towre676-cloud/hydrophone/receipts/symphony/clay_and_water_mobile.png

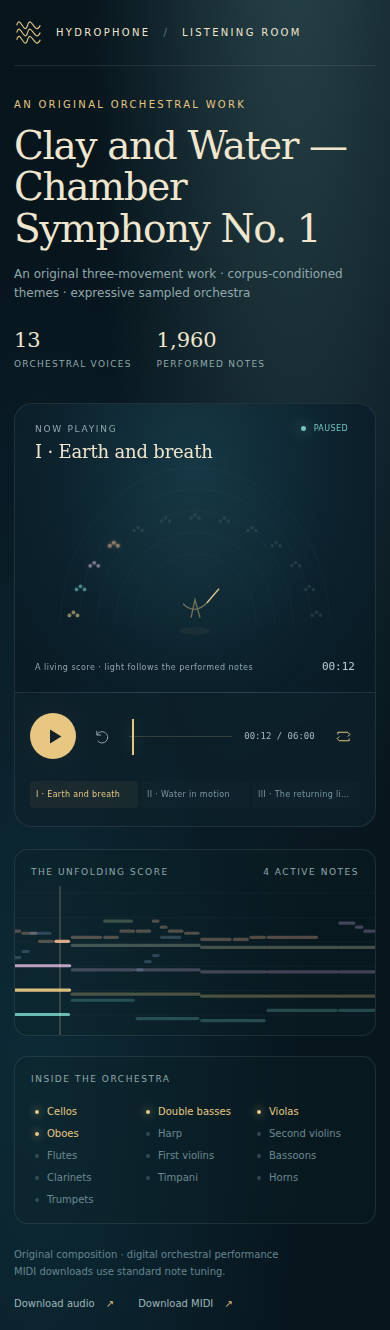
receipts/symphony/clay_and_water_mobile.png
