towre676-cloud/hydrophone/receipts/symphony/clay_and_water_desktop.png

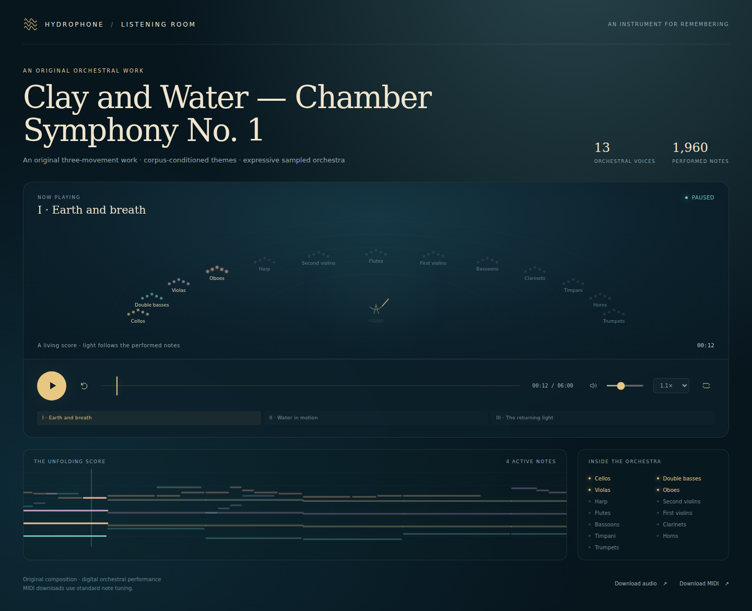
receipts/symphony/clay_and_water_desktop.png
