towre676-cloud/hydrophone/design/fusion_design/README.txt

FUSION INSTRUMENT - ENGINEERING DESIGN 0.2 - 24 OCTOBER 2026

Start with output/Fusion_Instrument_Design.pdf. Dimensions are nominal, not
measured results. The OpenSCAD file is a fit-check assembly; clamps, seals,
membrane loading, spring temper and sensor calibration need coupon checks.
No hardware has been assembled, bought, tested or connected to repositories.

The physical object uses one clay-controlled shared bridge, four dry strings,
one vented water cell/hydrophone, a slow writer and independent vibration
reference. Dyletsky supplies spelled musical targets; five research repositories
supply distinct mathematical services through proposed unit-bearing contracts.

Run standard-library design arithmetic:
    python src/fusion_reference.py

Run the illustrative passive model (NumPy, SciPy, Matplotlib required):
    python model/passive_instrument_model.py

Open src/Fusion_Instrument_Layout.scad in OpenSCAD. The generated CSG confirms
syntax only; no fabrication/strength claim follows from a rendered assembly.

The new ratio fixture is not a replay of original Dyletsky JavaScript. Source
documents recovered are Claycompute.txt, claycompute_exposition.md.pdf,
dyle2.txt and dyle3.txt. The original hydrophone-and-string description was
not recovered; the combined mechanism is a new, explicitly proposed design.

SOFTWARE INTEGRATION 0.2
Read dyletsky/README.txt for recovered source engines, exact verification and
the executable bridge to the Review Hidden Math session. Open
dyletsky/output/Dyletsky_Fusion_Audition.html to audition offline. The physical
adapter remains disabled; the software now generates and checks real targets.
The cross-session handoff is Fusion_Physical_Integration_Handoff_20261024.json.
