towre676-cloud/hydrophone/hardware/requirements-alignment.txt

# Optional offline electrical loopback timing; no device access.
numpy>=1.24,<3
scipy>=1.10,<2
