towre676-cloud/hydrophone/design/fusion_design/dyletsky/fusion_bridge_notes.txt

FUSION SESSION INTEGRATION - ACTUAL SOFTWARE TARGETS, SYNTHETIC OBSERVATIONS
24 October 2026

The source archive is the other session's Fusion_Decision_Engine_20261024.zip, SHA256 699965824802bb8d4a1157fc5e74255bb4b697c9376a08e1712a056bc66532e2. Safe extraction rejected absolute paths, parent traversal, symbolic links and destinations outside the extraction root. Every file listed in the archive manifest matched its recorded size and SHA256. The copied fusion_engine.py is byte-for-byte unchanged, SHA256 5acc5d9fdfd2a9390f4d73f445bad25b82bbe58a9e322534b57e6dfa92f54cbc. The complete independent replay exactly equals the archived results.json: 600 interval-panel cross-checks, eight minimal three-state obstructions in its original model, original action/task/state costs 1/3/7, failure at closed noise radius 1/2, and archived 12-pitch music Gram determinant 52002816.

The bridge imports that recovered engine and calls its actual optimal_panel function. It does not implement another hypergraph solver. It also calls the recovered independent interval-arrangement checker on the selected action panel. Its API assumes a finite hypothesis pool, fixed acceptable-action sets, independent rectangular bounded reading sets, closed interval endpoints, fixed non-state-changing probes or an explicit reset contract, and a common normalized noise radius. These assumptions have not been established for the proposed physical instrument.

The actual Dyletsky score export used for this run contains 68 software-generated events. The bridge reads its four calibration targets: C4 at 261.626 Hz, D4 at 292.39573306577114 Hz, E4 at 326.759563456652 Hz, and G4 at 391.1253463782126 Hz. These are genuine outputs of the recovered software engine and its export pipeline, not measured string frequencies. Each target is retained with its source spelling, engine identifier, offset in cents and manual-tuning marker. The score file's SHA256 is stored in fusion_bridge_results.json. This bridge tests calibration decisions; the separate event compiler handles the polyphonic common-exciter score and is not implemented here.

For each target, the new application declares six synthetic hypotheses: pitch error -4, 0 or +4 cents relative to that target, crossed with a binary synthetic sensor nuisance code. Candidate actions add either -4 or +4 cents exactly, and a successful action leaves absolute error at most 4 cents. The declared coarse reading has bounded error 2 cents; the fine reading has bounded error 1/2 cent. Their illustrative costs are 1 and 4. A nuisance-code reading costs 2. The recovered exact engine returns action panel coarse_pitch at cost 1, tuning-task panel fine_pitch at cost 4, and full-state panel fine_pitch plus sensor_nuisance_code at cost 6 for all four targets. Costs are not measured time, money, energy or speedup.

At a normalized coarse reading of -1/2, four hypotheses remain compatible: either -4 or 0 cents error, and either nuisance code. The tuning task and complete state both remain unresolved. Nevertheless, RAISE_4_CENTS is successful for all four hypotheses, yielding final error 0 or +4 cents under the declared action model. At +1/2 the corresponding common action is LOWER_4_CENTS. This explicitly retains a useful decision without forcing complete material-state identification. The recovered checker also verifies that enlarging the coarse closed noise radius to 1, meaning 4 cents, breaks the guarantee at the shared endpoint.

The exact certificate concerns the rational normalized-cents table only. Nominal frequencies computed from cents are approximate display arithmetic. Real frequency-estimation uncertainty, drift, action error, clay response, string coupling, unknown water-path response and hydrophone calibration have not been bounded by this example. An out-of-population physical state is not covered. A real correction would require measured actuation limits, remeasurement and a calibration contract. There are no fabricated physical measurements, no physical controller, no new theorem claim and no claim that the package solves the full rheology or control problem.

Run from any directory with Python 3.10 or newer: python /absolute/path/to/dyletsky/fusion_bridge.py --score /absolute/path/to/dyletsky/output/instrument_score.json. The default output is output/fusion_bridge_results.json beside the bridge. Only the standard library is required. Physical execution is disabled in every emitted decision.
