towre676-cloud/hydrophone/docs/INTEGRATION.md

# Shared object and computing boundary

The design session's current Engineering Design0.2 packet is preserved in `design/fusion_design/`. The current computing session supplies `computing/`, its examples/tests, and the earlier Fusion and object handoff archives. The repository is now the shared durable source for these parallel outputs.

The authoritative current design interface description is `design/fusion_design/src/fusion_contracts.json`. The older `docs/handoffs/acquisition_contract.json` remains a draft checkpoint; the design PDF and CAD now supply geometry that was unavailable when that checkpoint was written. Sensor calibration, synchronization, physical drivers and actuator limits remain unqualified in both.

The design packet assigns DynaComp the measured dynamical-model/reduction role; Singularity finite experiment distinguishability; PerfectJet recoverability and bounded decisions; PerfectPower finite program/resource planning; nonlinearhamiltonian a supported single-modal conservative symbolic reference; and Dyletsky labelled pitch targets and excitation phrases. This local computing layer provides concrete grouped interval and score/run formats for those boundaries. It does not claim that external repository APIs have already been imported or executed.

A joint experiment begins with ordered preparation of the clay cartridge, records a declared geometry and time, and preserves slow force/displacement alongside string, direct-vibration and hydrophone channels. Raw paths, hashes, units, calibration records and clock maps accompany the record. One physical excitation is one acquisition group even if it yields many features. State-changing probes need independent prepared replicates or complete sequence models; merely labeling a probe reset does not prove it leaves the target memory intact.

The first acceptance task is to determine whether prepared history differences are observable under confirmation cartridges or days, and whether a bounded diagnostic decision can be replayed. Dynamic transfer features can identify operators while concealing initial state. Slow force complements them in the illustrative SLS model. The new finite-hold calculation propagates memory relaxation instead of freezing its value throughout a nonzero dwell.

Hardware command readiness remains separate from model decision sufficiency. The physical owner must supply measured travel, force, tension and speed envelopes, calibrated transfer paths, timing and drive limits before any recommendation is mapped to actuation. The existing code records this boundary explicitly and emits zero hardware commands.

The prior0.1 packet remains byte-preserved in archives/Fusion_Instrument_Design_Package_v0_1_20261024.zip and its PDF is docs/reports/Fusion_Instrument_Design_v0_1.pdf. The new instrument/ layer adds common-input WAV rendering, joint digital-channel tone features and signed slow writer-port work. The original computing/ layer retains its grouped finite planner, memory enclosures and acquisition auditor.

Canonical fusion.run/1 uses raw_files and the computing auditor. instrument analyze-run accepts that canonical record when explicit analysis.tones frequencies and channel selections are added, preserving logger_time_s. Its smaller standalone record is named hydrophone.signal-run/1. Both score variants retain fusion.score/1 with explicit start_s/onset_s and source_amplitude/amplitude aliases; contradictory aliases reject, and voice identifiers are not silently remapped. The archived36-row twelve-class music proxy and recovered37-row/43-row spelled engines remain distinct.
