towre676-cloud/hydrophone/docs/reports/Fusion_Instrument_Design.pdf

ENGINEERING DESIGN 0.2 / 24 OCTOBER 2026

# A physical fusion instrument

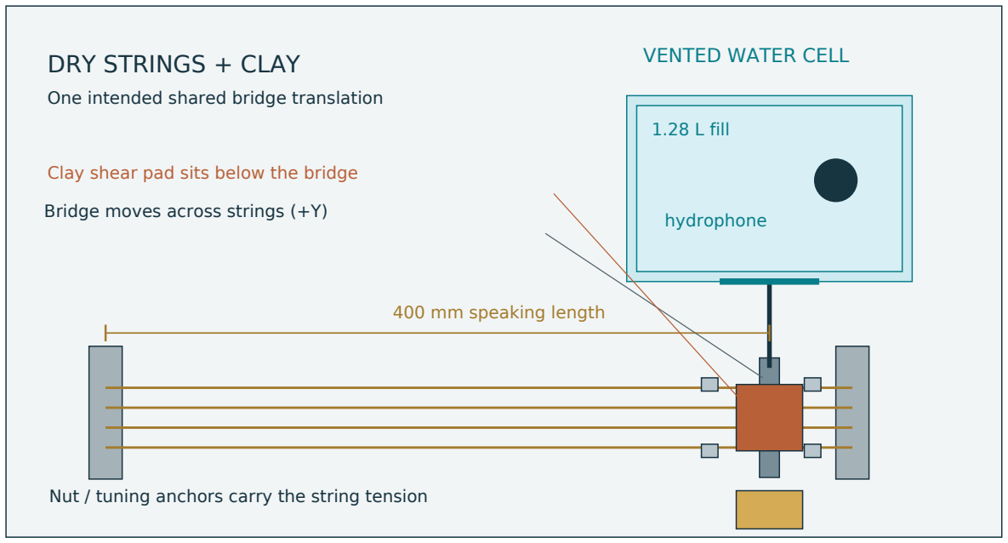
[picture p3: figure]
DRY STRINGS + CLAY; One intended shared bridge translation; VENTED WATER CELL; 1.28 L fill; hydrophone; 400 mm speaking length; Bridge moves across strings (+Y); Clay shear pad sits below the bridge

FUSION / nominal design; no assembled hardware or measured material results | 01

A clay-controlled musical measurement instrument. Four dry strings share a transverse bridge whose motion shears a replaceable clay cartridge. A removable dry rod drives a diaphragm in a vented water cell. A hydrophone records that water-coupled response while a separate vibration reference and a slow force/displacement instrument reveal what the clay actually retains.

Nut / tuning anchors carry the string tension

600 mm

TOP VIEW / millimetres / nominal positions

Rod detaches for clay writing; water never contacts clay or strings.

Dyletsky supplies spelled pitch targets, interval priorities and musical drive phrases. DynaComp predicts selected outputs of a calibrated mechanical model. Singularity chooses distinguishing experiments, PerfectJet checks whether a requested decision is supported, PerfectPower schedules admissible finite drive programs, and nonlinearhamiltonian checks the conservative symbolic reference. Dyletsky score export and the other session’s Fusion decision bridge now execute; acquisition and physical repository adapters remain new work.

Delivered status. This packet supplies nominal geometry, an assembly layout, components, calibration protocol, data contracts and reproducible synthetic calculations. It is a preliminary engineering design, with an explicit path to a first physical experiment. It does not report an assembled object, verified material law, physical computing advantage or completed hardware integration. The recovered Dyletsky and Fusion software integration is documented in the added pages.

# Geometry and construction

FUSION / nominal design; no assembled hardware or measured material results | 02

BRIDGE SECTION / heights shown schematically; Z in mm

String saddle Z=125

Bridge Z=113..125

Flexure tops Z=95

Upper plate Z=86..89

Clay pad Z=78..86

Fixed plate Z=75..78

Leaf free length 40; thin axis is Y

Rod centre Z=85; offset carrier

Stop screws limit Y travel

Four-leaf guide: measure parasitic rotation. Anchors carry axial string load.

Item | Nominal geometry / location
Base / envelope | 600 × 320 × 12 plate; reserve total height 240. X is string direction; Y is bridge motion; Z is height.
Strings | Nut X=60; bridge X=460; afterlength anchor X=510. Y=54,66,78,90; saddle Z=125. Speaking length 400; afterlength 50.
Clay sandwich | 30 × 30 × 8 clay between 40 × 40 × 3 plates. Centre X=460,Y=72. Lower plate Z=75..78; clay 78..86; upper plate 86..89.
Carrier / flexures | Four leaves 40 × 10 × 0.30 spring steel, free Z=55..95, thin direction Y; centres X=424/486,Y=52/92. Bridge crossbar 12 × 72 × 12 at X=454..466,Y=36..108,Z=113..125.
Water cell | Internal X=380..540,Y=160..260,Z=35..135. Six mm walls; fill to Z=115. External extent 172 × 112 × 106. Vented removable lid.
Wet interface | Diaphragm centre X=460,Z=85; external plane Y=154. Forty mm clear aperture. Dry rod diameter 3, centre Z=85. Hydrophone centre X=500,Y=215,Z=80.

Base drilling, bracket holes and cable routes must follow purchased component drawings. The OpenSCAD assembly checks nominal fit and load-path arrangement; omitted fasteners, saddle caps, seals and electronics are not fabrication details inferred from the render. Use captive grooved saddles or light retaining caps for transverse string coupling and characterize their slip and damping.

# Mechanics that make it work

FUSION / nominal design; no assembled hardware or measured material results | 03

Separate axial load, clay writing and acoustic reading. Independent nut and end blocks carry string tension into the frame. Four leaf flexures in two Y-separated pairs resist bridge pitch and guide it laterally, so the clay does not carry the full axial string load. The upper clay plate moves with the carrier; its lower plate is fixed. The dry rod connects at Z=85 through an offset bracket below the Z=125 string saddle. The intended translation changes clay shear; actual motion can include parasitic rotation because string and rod forces act at different heights. Measure both sides of the carrier, include pitch as a model coordinate when needed, and reject records with uncontrolled normal loading or saddle motion. Pure translation and constant string height are design targets, not established constraints.

Use a non-drying modelling clay as one candidate specimen, weighed and batch-labelled. Compare it with a rigid spacer and a characterized elastomer. Non-drying clay is not automatically a calibrated or nonvolatile memory device: creep, oil migration, wall slip and contact evolution can dominate. A replaceable cartridge permits identical fixtures and independently prepared specimens. Add a removable side window or fiducials to observe shape and plate slip.

Operation | Initial design setting; to be validated
Slow writing | Manual micrometer or screw stage, inline 20 N nominal load-cell range, independent displacement readout. Begin at ±0.05 mm; extend toward ±0.5 mm only after measured checks. The latter gives nominal clay shear strain 0.0625.
Uncoupled write | Release the indexed dry rod before large clay writing strokes. Record force/displacement/history. Reattach without detectable preload; record the new equilibrium and test reconnection repeatability.
Acoustic read | Begin below 10 micrometres bridge dynamic amplitude about its measured equilibrium; use low-level sweeps and ringdown. Hardware travel stops at ±0.6 mm are protection, not an allowed dynamic excursion.
Diaphragm coupons | Sixty mm disc / forty mm clear aperture; compare 0.10 and 0.25 mm spring-stainless sheet. Clamp ring OD60, ID40, thickness5; eight M3 clearance holes on 50 mm bolt circle. Gasket and wet sealing require leak and creep checks.

A useful screening estimate is k = 16πD/a² with D = Et³/[12(1−ν²)]. At E=200 GPa, ν=0.3 and a=20 mm, the ideal dry central-point stiffness is about 2.30 kN/m for 0.10 mm sheet and 35.96 kN/m for 0.25 mm. These are not assured wet stiffnesses. At 30 mm centre depth, hydrostatic loading alone gives an idealized 40 micrometre central deflection for the thin coupon. Measure tangent stiffness around the actual wet equilibrium, including water, clamp and rod loading.

# Sensing and electrical interfaces

FUSION / nominal design; no assembled hardware or measured material results | 04

Use one multichannel audio interface for all phase-sensitive acoustic channels. A Behringer UMC1820 is a candidate with eight analogue preamps, 24-bit/96 kHz conversion and phantom-power support [H2]. Begin at 48 kHz with fixed gain and disabled automatic processing. An Aquarian H2dX is an audio-band candidate; its 25 × 46 mm body fits the cell, and its XLR output needs phantom power [H1]. The manufacturer states that response depends on the preamp, power and cable. Calibrate the assembled chain; its advertised bandwidth does not calibrate this small reflective tank.

Audio input | Signal / purpose
1 | Hydrophone in water. Phantom power only as required by the matched hardware.
2 | Optional air microphone outside the cell: audible result and airborne crosstalk.
3 | Optional second pressure point / reference microphone; mark unused if absent.
4 | Optional diagnostic; preserve full simultaneous acquisition initially.
5 | Buffered bridge vibration reference. A piezo channel gives AC strain/voltage, not calibrated DC displacement.
6 | Buffered base/reference vibration channel to expose frame transmission.
7 | Electrical command loopback through a correctly rated line-level attenuator.
8 | Measured drive proxy or synchronization marker, appropriately conditioned.

Acquire slow load-cell force, independent displacement and water/room temperature on a separate DC-capable logger. Audio inputs cannot measure static clay displacement or long relaxation reliably. Record a common synchronization event in both systems and estimate offset and drift; do not infer synchronous clocks merely because both devices use USB. The minimum design-resolution target is 0.01 N force and 0.01 mm slow displacement, with uncertainty measured across the used range. These are acceptance targets, not promised sensor performance.

Drive a dry-mounted exciter through a current-limited low-voltage amplifier. The Dayton DAEX25 family is a candidate; the installed panel determines its response [H3]. An audio interface line output must feed an amplifier input, never a voice coil directly. Keep amplifier outputs, sensor conditioning and phantom-powered microphone inputs distinct. Nylon strings require optical or piezo pickup methods; magnetic guitar pickups do not sense nonmagnetic nylon. Keep electrical connectors above the water tray and use the manufacturer-supplied power equipment.

A concrete slow-logger candidate is the Phidgets DAQ1500_0 bridge interface with a compatible USB VINT hub. Its stated maximum 50 Hz rate suits slow holds, not audio. Choose and calibrate the force transducer separately: a cheap 5 kg cell with roughly 0.025 N repeatability cannot be presumed to meet the 0.01 N target. Never attach a high-force contact indicator to the bridge during free acoustic reads without measuring its added loading.

# The shared physical model

FUSION / nominal design; no assembled hardware or measured material results | 05

Let q contain measured generalized displacements, v their velocities, y=aᵀq the clay deformation coordinate and z a relaxing internal coordinate. A deliberately modest reference law is Mq̈ + Cv + K₀q + a[k∞y + kₘ(y−z)] = Bu, with ż=(y−z)/τ. Positive mass and stiffness and positive-semidefinite damping make this standard-linear-solid model a useful passive baseline. Plastic shape retention requires an additional measured law; it is not supplied by renaming z as memory.

For fixed coefficients, E = ½vᵀMv + ½qᵀK₀q + ½k∞y² + ½kₘ(y−z)² obeys Ė = uBᵀv − vᵀCv − (kₘ/τ)(y−z)². This identity supplies a sign and energy-accounting check. If the write process changes stiffness, add Pwrite = ½k̇∞y² + ½k̇ₘ(y−z)², with corresponding terms for every other changed coefficient. Writing and retuning do work. A decreasing-energy proof for frozen coefficients cannot certify a live adaptive controller.

## Two failures that the hardware must expose

Acoustic blindness to a memory state. The incremental clay stiffness is k*(ω)=k∞+kₘ iωτ/(1+iωτ). It contains τ and the stiffnesses but not the initial z. Two preparation histories with the same coefficients can have different slow relaxation offsets and the same small-signal frequency response. An acoustic sweep alone cannot identify those histories. A successful persistent acoustic memory write must instead change geometry, contact, stiffness, damping or coupling in a repeatable way.

Pressure-only ambiguity. If Hobs(ω)=Gwater(ω)Hmech(ω) and Gwater is unrestricted and unknown, any nonzero candidate H̃mech can be explained by G̃water=Hobs/H̃mech. Unique material inference fails. An independent vibration reference, a fixed hydrophone mount and disconnected/empty/filled baselines are part of the instrument, not optional statistical refinements.

The Hamiltonian repository can check a chosen scalar modal submodel H(q,p)=p²/(2m)+kq²/2+αq⁴/4 in its supported single canonical pair q,p. Clay dissipation, creep and fluid losses remain explicit added terms. No classical-to-quantum identity implies quantum behaviour, an arbitrary finite observable closure, or a hardware speedup for this object.

# Dyletsky becomes a physical score

FUSION / nominal design; no assembled hardware or measured material results | 06

The recovered dyle2/dyle3 material identifies a weighted pitch-constraint system and a 17-spelling extension [L3,L4]. Its useful engineering role is to request labelled tuning targets and controlled phrases. In a fixed gauge, solve x* = argmin [(Jx−b)ᵀW(Jx−b)+λxᵀx]. With positive-semidefinite W and suitable gauge or λ>0, the normal equation is (JᵀWJ+λI)x*=JᵀWb. Convert a cent offset to frequency by f=fET2

x*/1200. Preserve

spelling labels; a sound frequency alone does not distinguish G-sharp from A-flat.

The first physical version has four simultaneous string voices and manual tuning pegs. It does not independently realize all seventeen software pitches. Full rapid musical retuning would need a later measured motorized mechanism. Electronic oscillator changes do not by themselves retune the physical strings. The four-note example below is a new simple-ratio design fixture, not a replay of an original Dyletsky composition.

String | Target Hz | Offset cents | Ideal tension N
C4 | 261.626 | +0.000 | 9.892
D4 | 294.329 | +3.910 | 12.519
E4 | 327.032 | -13.686 | 15.456
G4 | 392.438 | +1.955 | 22.256

This fixture anchors C4 to 261.6256 Hz and uses ratios 9/8, 5/4 and 3/2 for D4, E4 and G4. The ideal rigid-end string relation is f=(1/2L)√(T/μ), or T=μ(2Lf)². The table assumes L=0.400 m, diameter 0.50 mm and nylon density 1150 kg/m³. Measure linear density from a long sample and use observed pitch to tune; compliant supports, stretch and endpoint effects make the calculated tensions estimates.

For a controlled experiment, freeze a tuning and phrase, prepare a clay history, then record the same input and all outputs. Compare identical phrases under distinct clay preparations, and identical preparations under distinct phrases. This crossed design separates what the score does from what the material remembers. Record every manual retuning event as a state-changing action. A loss-sensitive response can be heard, but a musical impression is not a calibrated material measurement.

The implemented software score carries pitch spelling, octave, requested hertz/cents, duration, voice, phrase and seed. The common-input plan adds channel and amplitude-calibration requirements. The original simple-ratio fixture above remains separate from the recovered Gen2 targets in the added integration pages. Musical fields become operator inputs only through a measured mapping. A Hessian of musical preference is not automatically a mechanical stiffness matrix.

# How the repositories coordinate

FUSION / nominal design; no assembled hardware or measured material results | 07
Service | Existing machinery and proposed instrument job
DynaComp | Compile a calibrated model for a chosen output; replay EA=GE, EB=H, DE=C or a stated residual bound. Account separately for omitted physical modes and model discrepancy.
Singularity | Choose finite distinguishing sensor/probe panels. For declared box errors, require candidate separation greater than twice the error. Report ambiguous histories.
PerfectJet | Check target recoverability and bounded decisions in its supported finite linear chart; keep uncertain choices unresolved. Track the declared history/protocol state.
PerfectPower | Count, rank and optimize chronological drive words under one exact integer cost budget: 0-256, at most 16 actions, costs 1-16. Additional limits need an explicit guard-state adapter.
nonlinearhamiltonian | Verify supported conservative symbolic identities and observable derivatives. Keep dissipation and history outside that symbolic claim.
Dyletsky | Provide labelled pitch targets, interval priorities and reproducible excitation phrases. Four physical voices first; seventeen labels retained in the data model.

The common contract is a measured run. Store raw multichannel WAV plus slow CSV, sensor positions, units, calibration factors and uncertainty, specimen/history ID, gain settings, measured drive, clock alignment, temperature, clay mass, missing-sample/clipping flags and exact source references. Features retain the raw run IDs. A proposed model contract then carries A/B/C, sample timing, validity domain, state/input boxes and separate calibration, discretization, reduction and physical-discrepancy budgets.

Current source code supports the mathematical services above, but no inspected repo supplies this completed acquisition or actuator adapter. The packet includes explicit interface definitions and an offline evidence gate. Its Dyletsky score compiler and recovered Fusion software bridge now run; physical integration remains unimplemented. The gate rejects synthetic data as physical evidence. A field-complete record still needs scientific validation; metadata presence alone cannot certify accuracy.

Version details matter. The audit read explicit main branches on 24 October 2026 and retained Git blob hashes; these identify file contents, not repository commit snapshots. PerfectPower has a different default branch. Integration should record a full tested commit for every dependency and use its documented argument types and size limits. An exact rational fit is exact arithmetic on a nominal model, not an exact law of clay. PerfectPower words consume the specified budget exactly; an upper-budget menu needs a sum over exact budgets or a validated padding encoding.

# The first physical experiment

FUSION / nominal design; no assembled hardware or measured material results | 08

Establish a repeatable instrument before claiming memory. With the clay removed or replaced by a rigid reference, record electronics loopback, bridge/base vibration and hydrophone noise. Characterize the dry bridge with the rod disconnected, then with the diaphragm connected and the cell empty, then at fixed water depth. Measure dry and wet static tangent stiffness, settling and rod reconnection variability. If diaphragm or frame loading masks cartridge differences, change the membrane or coupling before adding software complexity.

Test clay histories under controlled present conditions. Prepare independent cartridges with a repeatable low-amplitude conditioning cycle. Compare a specified hold, a loading/unloading loop and an untouched reference, each recorded with measured force, displacement, duration and relaxation time. Begin at 0.05 mm write travel with the rod released. Increase only within the measured elastic/controlled operating region of the fixture. Reconnect the indexed rod and record equilibrium before a low-level sweep. Use slow steps and holds to fit relaxation time; the hydrophone does not supply the DC record.

Separate signature, retention and useful computation. First ask whether preparation changes the response beyond remounting, temperature and measurement uncertainty. Then ask whether that difference survives predefined waits, for example 1, 10 and 60 minutes, without continued writing power. Compare different histories at matched present geometry and include repeated detach/reattach controls. Only after reliable physical discrimination should the device attempt a task such as classifying an incoming vibration pattern or filtering a known waveform.

Gate | Predeclared result needed
Read does not rewrite | Repeat at least ten low-level reads. Feature drift from reading must remain inside its independently estimated repeatability interval.
History is observable | Use full sensors initially. A finite candidate pair is accepted as separated only when declared uncertainty intervals do not overlap; otherwise retain ambiguity.
Transfer is stable | Log water depth/temperature and bridge motion. Reject clipped, loose, slipping, leaking or unsynchronized records.
Generalization | Freeze preparation, features and thresholds on development cartridges; evaluate at least six additional cartridges on a later day with the declared controls. This is a pilot, not a universal reliability estimate.
Computational value | Compare with direct low-order rheology and ordinary digital filters on the same task, error, latency and setup-inclusive energy/cost. A four-string prototype may need no model reduction.

No guarantee of a tenfold gain, uniqueness, nonvolatile retention or novelty is implied. The immediate scientific payoff is a well-instrumented test of whether the proposed physical memory is visible, persistent and usable. A negative result still tells us which coupling or measurement needs redesign.

# Parts and spending envelope

FUSION / nominal design; no assembled hardware or measured material results | 09
Part / quantity | Specification and cost status
Hydrophone / 1 | Aquarian H2dX with appropriate cable and phantom-powered preamp [H1]. Manufacturer page displayed US $229 on 24 October 2026; verify selected connector/cable total.
Audio interface / 1 | Eight analogue input candidate: Behringer UMC1820 [H2]. Planning allowance $200-350; not a vendor quote. Existing suitable equipment can be reused.
Exciter / amplifier | Dry audio exciter, matched current-limited amplifier and proper input/feedback conditioning [H3]. Allow $80-200, subject to parts selection.
Mechanical assembly | 600×320 base, anchor blocks and pegs, carrier/flexure clamps, cartridge, cell, gaskets, rod disconnect, coupon sheets and spill tray. Allow $450-1,200; custom machining/lab labour may exceed this.
Slow sensing / stage | 20 N nominal force range, bridge conditioning, DC logger, independent displacement instrument, manual micrometer and temperature sensors. Allow $350-900; accuracy/clock requirements drive selection.
AC sensing / consumables | Buffered piezo/reference pickups or optical vibration reference, cables, clay, elastomer/rigid controls, nylon strings and spare seals. Allow $150-400.

Planning total: approximately $1,460-3,280 before tax, shipping, labour, computer and specialist calibration. Only the displayed $229 hydrophone price is source-verified here; the remaining bands are engineering allowances, not shopping claims. Laboratory force/vibration metrology can raise the total substantially. No order has been placed. Buy or fabricate the single cartridge/flexure/diaphragm coupon fixture first; verify stiffness and readout before committing to the full enclosure.

Cut-list starting point: one 600×320×12 base, two 40×40×3 cartridge plates, four 40×10×0.30 leaf coupons with additional clamp engagement outside the free length, one 12×72×12 bridge and a stiff offset carrier. The cell has a 172×112×6 bottom; two 172×100×6 long walls and two 100×100×6 inset end walls give the declared 160×100 interior. Include solvent-bond/fastener design consistent with the chosen plastic; no unverified pressure rating is asserted.

Place a vent and hydrophone cable support in a splash lid above the 80 mm water depth; do not seal the cell into a pressure vessel. Inspect membrane-edge sealing and hydrophone clearance. The acoustic wavelength in water is several metres around these notes, larger than the cell: it is a coupled reflective near-field experiment. It is not an anechoic or far-field acoustic calibration system.

# A testable numerical example

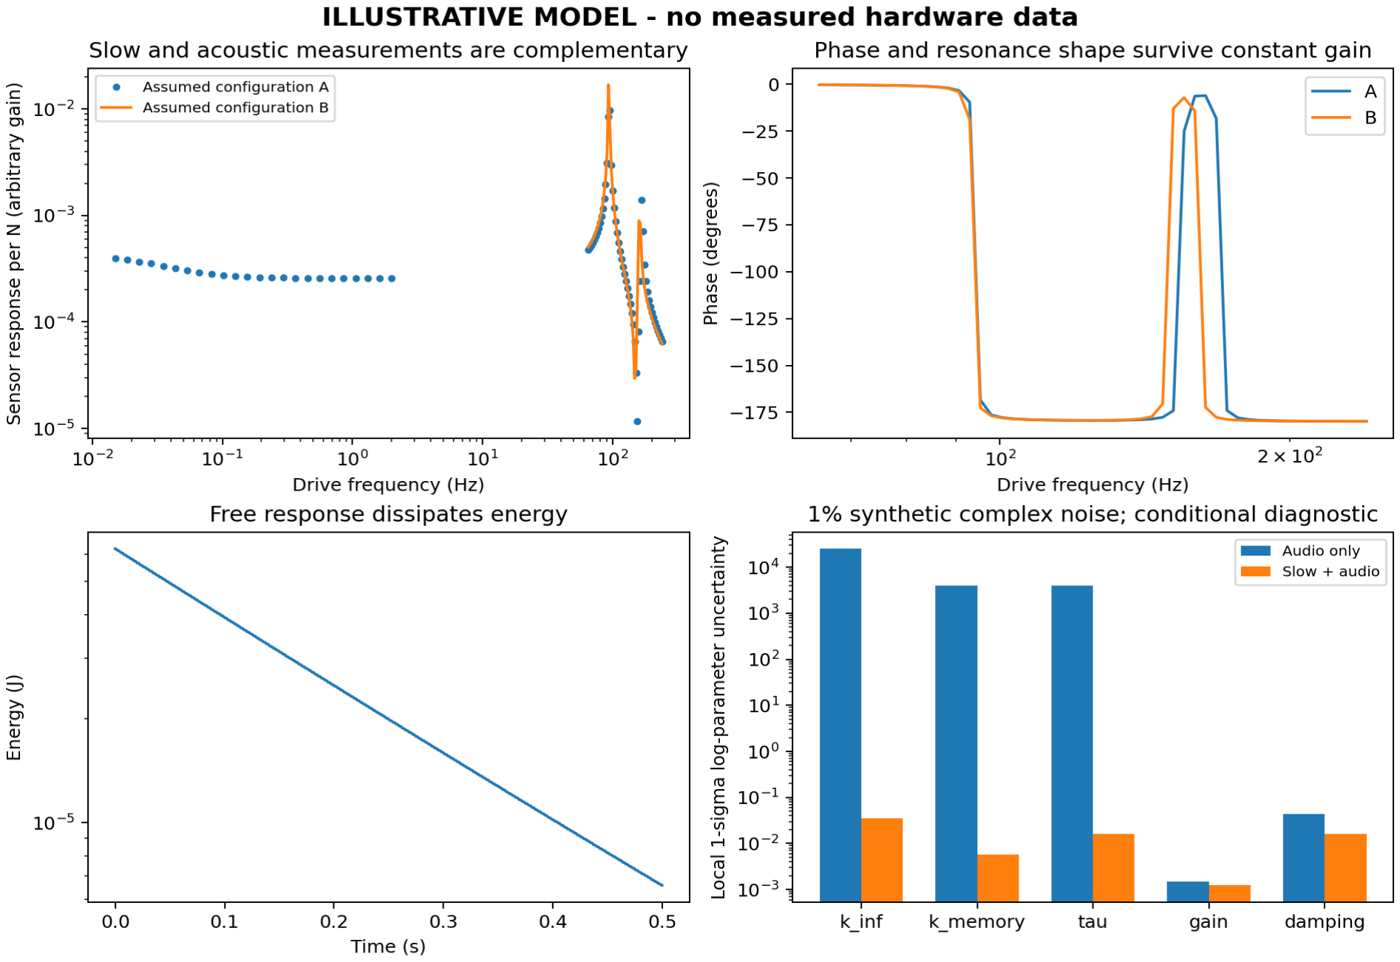
[picture p4: figure]

FUSION / nominal design; no assembled hardware or measured material results | 10

A reproducible two-mode standard-linear-solid example was run to test the measurement design. Its masses, stiffnesses, damping, forcing and gains are illustrative assumptions. The synthetic acoustic sweep is 65-240 Hz, and the slow experiment is 0.015-2 Hz; these are not predicted resonances or operating performance of the four-string geometry. All model files, raw synthetic outputs and assumptions are included.

Diagnostic | Illustrative result
Sensitivity condition | Audio only: 1.46×10⁸; slow plus audio: 207.9. Separate unknown constant slow gain: 208.7. Analytic derivatives and SVD used.
Parameter fitting | Thirty trials, declared 1% complex noise: relaxation-time relative RMSE 1.47%, conditional on the correct model and shared constant gain.
Energy replay | Free energy-balance residual below 2×10⁻¹⁸ J; separate state-space/transfer calculations agree within 5.84×10⁻¹⁶ relative error at six frequencies.

These calculations support adding the slow channel; they do not establish a real sensor sensitivity, clay retention time or physical speedup. Arbitrary frequency-dependent water or sensor error would defeat the assumed identification problem. The delivered model notes state that limitation explicitly.

# Source record and handoff

FUSION / nominal design; no assembled hardware or measured material results | 11

Recovered sources. [L1] Claycompute.txt, current Library read, especially lines 409-508: deformable material as a slow control layer for an acoustic/electromechanical substrate. [L2] claycompute_exposition.md.pdf, current extracted-text read: later cavity/piezo architecture. Its high-frequency and economic claims were treated as proposals, not established specifications for this design. [L3] dyle2.txt, lines 1-230 and 490-679: weighted constraint tuning and seventeen spelled pitch classes. [L4] dyle3.txt, lines 1-170: the pitch-field framework; this read does not validate every historical or empirical claim in that long draft.

The exact original hydrophone-and-string apparatus was not recovered in the selected source material. The mechanical combination in this packet is therefore a new design, not a purported restoration of its historical dimensions. Earlier conversation fragments contain incompatible scales and unsupported sensing assertions; those numbers were not used as engineering specifications.

L1 / clay source (https://chatgpt.com/library?file_id=libfile_313310e9f8508191841b84e39fe135fa&account_id=personal)

L2 / clay exposition (https://chatgpt.com/library?file_id=libfile_04d86703cf5c819182cea2a372a0f9ae&account_id=personal)

L3 / Dyletsky source (https://chatgpt.com/library?file_id=libfile_2f22625157bc819192ee648aac5dc0fb&account_id=personal)

L4 / Dyletsky continuation (https://chatgpt.com/library?file_id=libfile_5d6733f555908191a81bd8de72503bf1&account_id=personal)

H1 / Aquarian manual and product (https://www.aquarianaudio.com/AqAudDocs/H2dX_manual.pdf)

H2 / Behringer interface (https://www.behringer.com/en/products/0805-AAN)

H3 / Dayton exciter family (https://www.daytonaudio.com/product/1087/daex25-sound-exciter-pair)

H4 / Phidgets slow bridge logger (https://www.phidgets.com/?prodid=957)

Current repository main sources were inspected for DynaComp, singularity, PerfectJet, perfectpower and nonlinearhamiltonian. Full paths, content hashes, current API limits and caveats are in evidence/repository_audit.txt. These source inspections were read-only; no repository tests, commits or physical adapters were falsely reported as completed.

Handoff boundary. Begin with the coupon assembly and full simultaneous sensing. The electronics/acquisition owner builds synchronized raw logging and calibrated drive/reference channels. The mechanical owner measures dry/wet stiffness and cartridge repeatability. The repository owners consume the same measured run contract and publish independent replay outputs. The existing Fusion theorems, adversary and literature work can evaluate this concrete object without needing to invent its coupling path.

# Recovered Dyletsky integration

FUSION / nominal design; no assembled hardware or measured material results | 12

The actual source engines now execute headlessly. The v6 source and Gen2(3) source are preserved byte-for-byte, with Library identifiers and SHA256 hashes. React and Three.js are not needed for the extracted numerical modules. The new Gen2 scheduler injects a seeded random stream and retains source phrase transitions, style flow, register-specific solves, note proposals, durations, and both local and phrase memory. It exports fusion.score/1 and fusion.instrument-plan/1.

Verified engine | Distinct source model
v6 / 37 rows | 17 spelled columns, 16 free after fixing C. Thirteen static strategies. Exact reduced unweighted Gram determinant 508,958,496. Source ET means uniform weights, not zero offsets.
Gen2(3) / 43 rows | Seventeen chain spellings, 16 free after fixing C. Eight static strategies. Exact reduced unweighted Gram determinant 3,564,531,008. Its interval targets and spelling rules differ from v6.
Independent replay | All 21 static outputs checked against independently reconstructed Fraction solves and NumPy augmented least squares. Maximum offset discrepancy 8.53×10⁻¹⁴ cents. Source/extraction JS equality and selected seeded proposal functions also pass.

Semantic differences are retained explicitly. v6’s eight m3-labelled rows use augmented-second spellings such as C to D-sharp; Gen2’s minor-third rows use C to E-flat. Their fifth and third cent targets differ. v6 legacy wRMS squares the weights inside the residual; the conventional weighted RMS is exported separately. Gen2 averages twelve-pitch-class weights within each interval family, removing pitch-specific locations. Its modal and cadence static models therefore differ only by scale before regularization. These are source properties, not new physical laws.

The new deterministic Gen2 example emits 68 note events across five visited phrase categories and four distinct pitch spellings. Seventeen labels are supported, but this run does not establish wide musical diversity. Musical energy is a score heuristic, not joules. The original room, drones, percussion and browser component remain archived; the headless scheduler omits their audio-side random draws and mode changes. It is an adaptation of the source rules, not a bit-for-bit browser performance replay.

The single-file offline audition uses the original recovered Web Audio note synthesizer on the saved events. Its syntax, controls and 68 event graph constructions pass a mocked DOM/audio test. Actual browser playback and audible quality were not tested because this runtime had no browser executable. The CLI score and numerical integrations do not depend on browser availability.

# Shared score and decision loop

FUSION / nominal design; no assembled hardware or measured material results | 13
Gen2 fixed target | Hz | Offset cents
C4 | 261.626000 | +0.000000
D4 | 292.395733 | -7.500395
E4 | 326.759563 | -15.131752
G4 | 391.125346 | -3.849868

The score enters one common physical drive input. Eight software voices are mixed into the proposed shared exciter channel. Four dry strings supply four manually tuned resonances; changing a digital tone does not retune them. Every event preserves spelling, source engine, time, phrase, cent offset and frequency. The emitted plan marks its amplitude as normalized digital command, not force or pressure. Physical execution is disabled until the drive and sensing chain is calibrated.

The other session’s actual Fusion Decision Engine is integrated. Its recovered fusion_engine.py is copied unchanged and its complete archive replay matches the stored results: 600 interval-panel checks, eight original minimal obstructions and the archived music determinant. The new bridge calls its real optimizer and independent interval-arrangement checker using these four genuine software targets. It does not duplicate the solver or claim an extension of its theorems.

For each target, a deliberately synthetic table contains pitch errors −4, 0 and +4 cents crossed with a binary sensor nuisance. Candidate corrections add −4 or +4 cents, with final tolerance 4 cents. Declared coarse/fine reading bounds and illustrative costs yield action/task/full-state panel costs 1/4/6. At a boundary coarse reading, four hypotheses remain compatible, yet one correction meets the declared tolerance in all four. Thus a useful action can survive unresolved state identity. This is a conditional table certificate, not measured sensor economy or a physical speedup.

The actual four calibration targets are C4=261.626, D4≈292.395733, E4≈326.759563 and G4≈391.125346 Hz under the recovered Gen2 hex_nat setup. They replace neither the separate simple-ratio fixture nor a future measured string calibration. A manual correction, estimator bound, clay-dependent shift or water-path error must be measured before using the synthetic decision result on hardware.

Run and hand off. From dyletsky/, execute node dyletsky_runner.mjs, node verify_extraction.mjs, python verify_algebra.py and python fusion_bridge.py --score output/instrument_score.json. Open output/Dyletsky_Fusion_Audition.html to audition locally. The top-level Fusion_Physical_Integration_Handoff_20261024.json records the source-package identifiers, shared schemas, completed checks and remaining physical work for the Review Hidden Math session.
