towre676-cloud/hydrophone/hardware/mechanics/generated/drill_table.csv

part | hole_axis | local_X_mm | local_Y_mm | local_Z_mm | diameter_or_tap_drill_mm | operation | depth_mm | notes
B01 | Z | 392 | 92 | 0 | 4.5 | THRU | 12 | globalX;localY=globalY+40;clampfoot
B01 | Z | 408 | 92 | 0 | 4.5 | THRU | 12 | globalX;localY=globalY+40;clampfoot
B01 | Z | 392 | 132 | 0 | 4.5 | THRU | 12 | globalX;localY=globalY+40;clampfoot
B01 | Z | 408 | 132 | 0 | 4.5 | THRU | 12 | globalX;localY=globalY+40;clampfoot
B01 | Z | 512 | 92 | 0 | 4.5 | THRU | 12 | globalX;localY=globalY+40;clampfoot
B01 | Z | 528 | 92 | 0 | 4.5 | THRU | 12 | globalX;localY=globalY+40;clampfoot
B01 | Z | 512 | 132 | 0 | 4.5 | THRU | 12 | globalX;localY=globalY+40;clampfoot
B01 | Z | 528 | 132 | 0 | 4.5 | THRU | 12 | globalX;localY=globalY+40;clampfoot
B01 | Z | 441 | 101 | 0 | 4.5 | THRU | 12 | claypedestal;counterbore underside7.5x4
B01 | Z | 441 | 123 | 0 | 4.5 | THRU | 12 | claypedestal;counterbore underside7.5x4
B01 | Z | 479 | 101 | 0 | 4.5 | THRU | 12 | claypedestal;counterbore underside7.5x4
B01 | Z | 479 | 123 | 0 | 4.5 | THRU | 12 | claypedestal;counterbore underside7.5x4
B01 | Z | 25 | 76 | 0 | 5.5 | THRU | 12 | anchorfoot;M5throughnut
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
