towre676-cloud/hydrophone/design/fusion_design/dyletsky/output/Dyletsky_Fusion_Audition.html

FUSION INSTRUMENT / SOFTWARE INTEGRATION 0.2

# Dyletsky supplies the score. The object supplies the response.

This offline audition uses the recovered Gen2 43-row tuning and note-selection rules, then its original Web Audio note synthesizer. The saved score retains eight software voices, spelled notes, five visited phrase types, local memory and phrase memory. Its deterministic scheduler is a new headless adaptation. Room rendering, drones and percussion are preserved in the archive but are not performed here.

Play saved scoreStopSave score JSON

Software audition only. No hardware connection.

The physical plan mixes the score into one common exciter input. Four strings provide four manually tuned resonant voices; this does not create seventeen independently tuned resonators. Musical energy values are heuristic score features, not joules. Measured force, displacement and hydrophone data remain separate.

## Four fixed-string calibration targets

Spelling | Target Hz | Offset cents | Source

The v6 37-row comparison engine is also preserved and verified in the package. It has different spelling rules and interval targets; the two systems are not silently combined. The 68-event seeded Gen2 demonstration visits four distinct spellings, rather than all seventeen available labels. This is a wiring and replay demonstration, not a claim of musical diversity or physical performance.
