towre676-cloud/hydrophone/design/fusion_design/model/free_ringdown.csv

time_s | q1_m | q2_m | v1_m_per_s | v2_m_per_s | z_m | energy_J | energy_balance_residual_J
0.0 | 0.0001 | -4e-05 | 0.0 | 0.0 | 0.0 | 6.219426343496253e-05 | 0.0
0.0001 | 9.958651252668146e-05 | -3.960899966751974e-05 | -0.008262293165557238 | 0.007810976977026302 | 6.189039301077134e-09 | 6.219024469873751e-05 | -1.513980403349681e-19
0.0002 | 9.835040542302885e-05 | -3.844126680696211e-05 | -0.016438696830417807 | 0.015518130007849832 | 1.2313087888883557e-08 | 6.218518673340486e-05 | -2.62578559287608e-19
0.00030000000000000003 | 9.630435585564078e-05 | -3.651211315560899e-05 | -0.024447681210069076 | 0.023023178726909115 | 1.830820571215412e-08 | 6.217809805785777e-05 | -2.480747744271032e-19
0.0004 | 9.34691090086817e-05 | -3.384656754055658e-05 | -0.03220956101107749 | 0.030230250774601886 | 2.4111897921427985e-08 | 6.216807995658392e-05 | -2.459075612222143e-19
0.0005 | 8.987325044944685e-05 | -3.0479078887481295e-05 | -0.03964735485259876 | 0.037046999878834704 | 2.9663800185146257e-08 | 6.215436675169489e-05 | -2.4704907046753746e-19
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
