towre676-cloud/hydrophone/design/fusion_design/model/synthetic_sweep.csv

frequency_Hz | real_mechanical_sensor_response_per_N | imag_mechanical_sensor_response_per_N | absolute_response_per_N
0.015 | 0.00038843441017157715 | -6.470416642357309e-05 | 0.0003937866429399434
0.018555809265737896 | 0.0003760838809901038 | -7.248299026253929e-05 | 0.0003830050514261893
0.0229545371670963 | 0.0003611300920419989 | -7.834265512099466e-05 | 0.0003695301273098984
0.02839600089706205 | 0.00034437399709295294 | -8.121910945369671e-05 | 0.0003538219801174437
0.03512738510370705 | 0.00032715270261287797 | -8.051784314314698e-05 | 0.0003369154402685258
0.04345447053256739 | 0.0003109557569882401 | -7.638831252113866e-05 | 0.00032020096360560284
0.05375552446306324 | 0.0002969446287036105 | -6.965211166517341e-05 | 0.0003050041461609053
0.06649848392775395 | 0.0002856748817609206 | -6.144286969476548e-05 | 0.00029220774169320685
0.0822622122816093 | 0.0002771289383355678 | -5.281849136676888e-05 | 0.00028211742500820536
0.10176279472501232 | 0.00027093369152165895 | -4.454307032762775e-05 | 0.0002745708475344122
0.12588606728438453 | 0.000266587624039434 | -3.7054572562174574e-05 | 0.00026915052041331087
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
