towre676-cloud/hydrophone/hardware/mechanics_completion/retainers_guard/generated/drill_table.csv

part | axis | local_X_mm | local_Y_mm | local_Z_mm | diameter_or_tap_drill_mm | operation | depth_mm | notes
RG01L | Y | 7 | 0 | 13 | 6.05 | REAM | 16
RG01L | X | 0 | 8 | 4 | 4.5 | THRU | 15 | M4mount
RG01L | X | 0 | 13 | 4 | 2 | REAM | 15 | locatingdowel
RG01L | X | 0 | 8 | 19 | 3.2 | CLEARANCE | 7 | pinchbolt entry
RG01L | X | 7 | 8 | 19 | 2.5 | TAP M3x0.5 | 8 | opposingjaw
RG01R | Y | 10 | 0 | 13 | 6.05 | REAM | 16
RG01R | X | 0 | 8 | 4 | 4.5 | THRU | 15 | M4mount
RG01R | X | 0 | 13 | 4 | 2 | REAM | 15 | locatingdowel
RG01R | X | 0 | 8 | 19 | 3.2 | CLEARANCE | 10 | pinchbolt entry
RG01R | X | 10 | 8 | 19 | 2.5 | TAP M3x0.5 | 5 | opposingjaw
RG03 | Z | 8 | 2.75 | 12 | 2.5 | TAP M3x0.5 | 4 | topdowncapstan
RG03 | X | 0 | 3.75 | 4 | 2.4 | THRU | 18 | M2fixedwebmount
RG03 | X | 0 | 7.75 | 4 | 2.4 | THRU | 18 | M2fixedwebmount
RG04 | Z | 8 | 2.75 | 18 | 2.5 | TAP M3x0.5 | 4 | topdowncapstan
RG04 | X | 0 | 5.75 | 6 | 3.3 | TAP M4x0.7 | 10 | tensionstud;10engagement
RG04 | X | 0 | 5.75 | 12 | 3 | REAMH7 | 8 | 3m6guidepin;8pressengagement
RG03 | Z | 15 | 2.75 | 12 | 1.25 | TAP M1.6x0.35 | 5 | shoe
RG03 | Z | 15 | 8.75 | 12 | 1.25 | TAP M1.6x0.35 | 5 | shoe
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
