towre676-cloud/hydrophone/design/fusion_design/output/Fusion_Instrument_Top_View.png

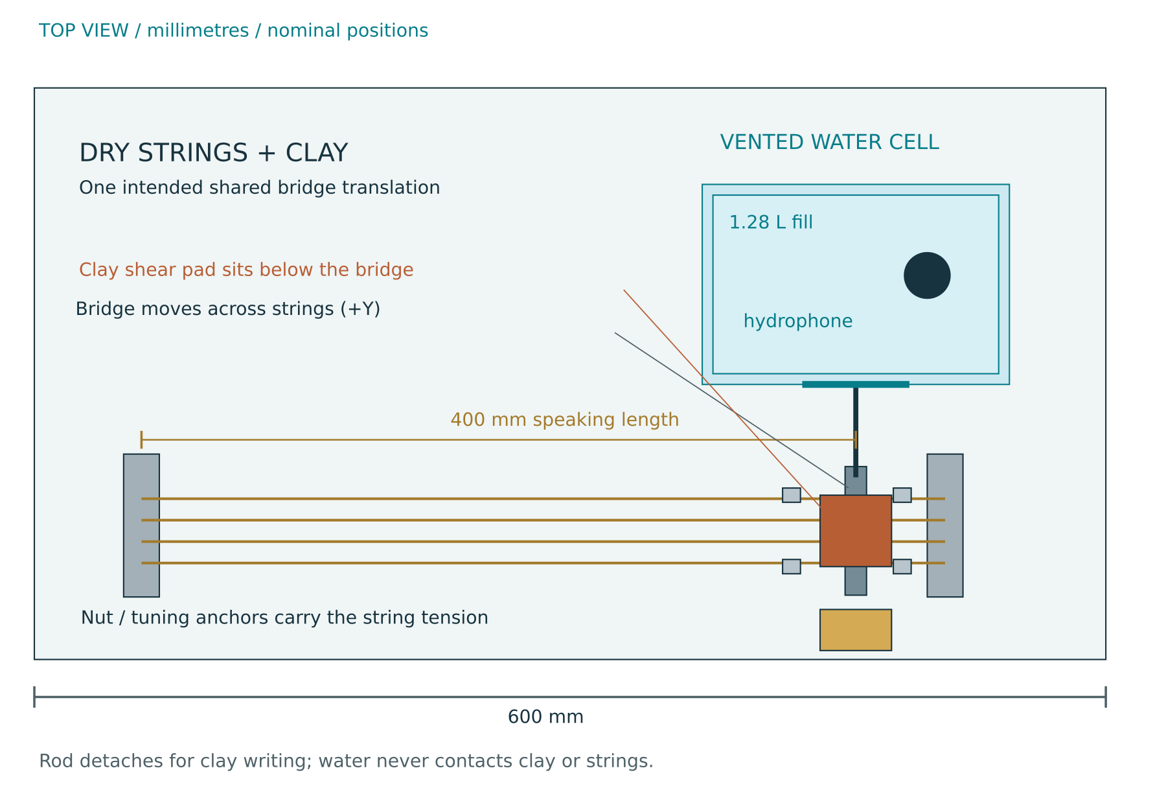
design/fusion_design/output/Fusion_Instrument_Top_View.png
