towre676-cloud/hydrophone/receipts/symphony/the_water_remembers_desktop.png

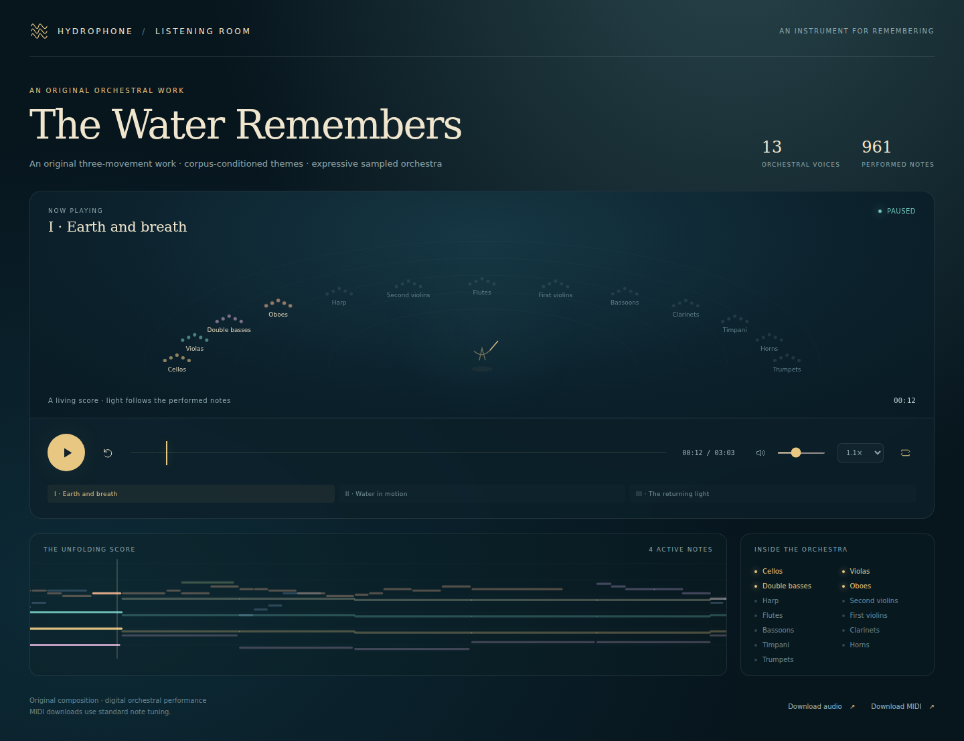
receipts/symphony/the_water_remembers_desktop.png
