towre676-cloud/hydrophone/receipts/symphony/the_water_remembers_mobile.png

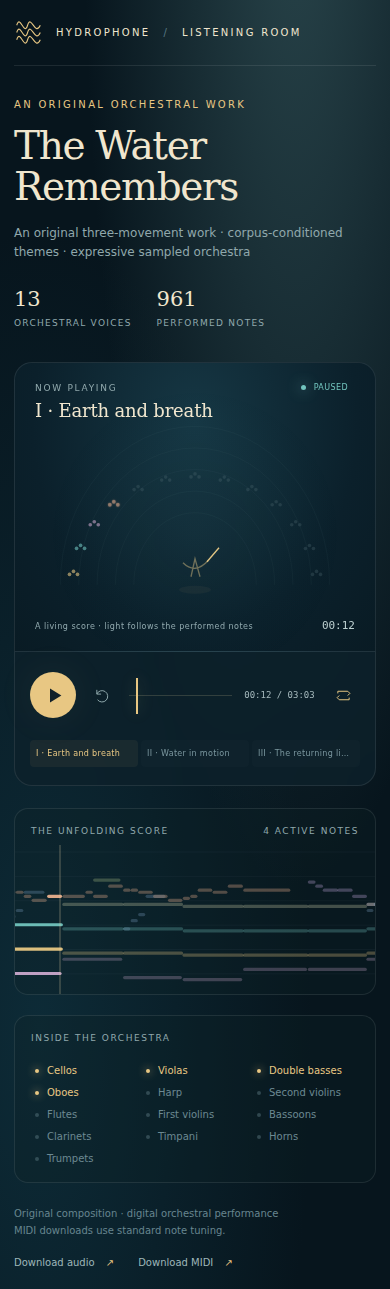
receipts/symphony/the_water_remembers_mobile.png
