towre676-cloud/hydrophone/hardware/mechanics_completion/generated/turning_table.csv

part | local_axis_start_mm | local_axis_end_mm | diameter_or_thread | notes
L01 | 0 | 15 | 6h9 | knobseat;mill0.5deepflatunderM3clamp
L01 | 15 | 69.5 | M6x0.5-6g | finelead;2mmrunoutbeforeintegralshoulder
L01 | 69.5 | 71.5 | 10h9 | integralshaftabutment;Ra0.4face;fillet≤0.15
L01 | 71.5 | 86.5 | 5.990..5.998 | bearingjournal;Ra0.4;coaxial≤0.01
L01 | 86.5 | 95 | M6x0.5-6g | twojamnutretainerthread
L06 | 0 | 2 | 14 | frontflange
L06 | 2 | 17 | 10.000..10.010 | mainbody;indexflat0.5deep
L06 | 17 | 22 | M10x0.75 | rearretainer
C01 | 0 | 2.2 | M3x0.5-6g | cellspigot;tipchamfer0.10max;2.20±0.05
C01 | 2.2 | 4.6 | hexAF5 | shoulder;loadfaceonly
C01 | 4.6 | 13.1 | M3x0.5-6g | rodend;tipchamfer0.15max;5.5nominalengagement
C03 | 0 | 2 | 5 | head
C03 | 2 | 28.2 | 2.994..3.000 | fullclevisshoulder
C03 | 28.2 | 33.2 | M2x0.4 | locknuts;washerID3.2clearsbeginningofthread
