towre676-cloud/hydrophone/hardware/mechanics/generated/params.scad

// Generated fromparams.json; millimetres;M03
base_origin=[0, -40, 0];
base_size=[600, 360, 12];
leaf_x=[400, 520];
leaf_y=[52, 92];
leaf_t=0.3048;
carrier_origin=[384, 40, 113];
carrier_size=[152, 80, 6];
clay_lower=[436, 56, 81];
clay_upper=[436, 56, 92];
clay_plate=[48, 32, 3];
clay_mount_x=[441, 479];
clay_mount_y=[61, 83];
string_y=[54, 66, 78, 90];
membrane_t=0.1016;
