towre676-cloud/hydrophone/hardware/mechanics_completion/ASSEMBLY.md

# M04 completion: nominal machining and state changes

M04 replaces the unfinished mechanical interfaces with the dimensioned parts in `completion.json`, the cut/drill/turning tables and the two SCAD files. The retained M03 files are immutable. Coordinates below are global millimetres unless explicitly called local. Commercial bodies remain maker-controlled parts, not shapes to manufacture from our envelopes. Physical acceptance remains a measured commissioning operation; nominal part dimensions no longer depend on an unspecified connector blank.

The first write limit remains **±5 N or ±0.25 mm, whichever comes first**, with live calibrated force and independent after-cell carrier displacement visible. The read criterion remains **≤10 µm actual dynamic diaphragm displacement about wet equilibrium**. Catch contact terminates a run. The conditional 20 N/0.5 mm arithmetic case does not authorize operation, and neither the catches nor hand-screw torque limit force automatically.

## Added envelope and retained base

The base remains M03 X0…600/Y−40…320. Add an 80×75×12 extension at (420,−115,0), butted against the original front edge, on an 80×95×6 underlap brace at (420,−115,−6). M5 bolts at X430/490,Y−90/−60 join the extension to the brace; X430/490,Y−30 join the brace to the existing base. Use M5×30 through-bolts, washers and nuts. Four Ø25×20 feet under the original base, at (20,−20),(580,−20),(20,300),(580,300), leave room for the brace and nuts. Each foot has a top M5 tap10 deep and uses an M5×20 through-base screw. Inspect lengths; a blind bottom is not a seating face. Felt pads, if fitted, are separately recorded thickness, not a geometric datum.

The parked hand knob reaches Y−140, and the right tuner/guard reaches X625. The nominal closed benchtop footprint is approximately **625×460 mm**. The open hood requires additional vertical service clearance given in `retainers_guard/ASSEMBLY.md`; it does not fit the original closed-object height envelope when open. Electronics remain on the separate dry rack. Drill the **new overlay**, not a changed M03 source file, using the completion and guard tables.

## Captive M6 lead and opposed thrust bearings

Turn L01 from Ø12 steel stock, length95, with local Y0 at global Y−125. The first15 mm is a Ø6 knob seat. Local15…69.5 is M6×0.5 external lead thread; provide a 2 mm root-diameter runout immediately before the shoulder. Local69.5…71.5 is an integral Ø10 thrust shoulder. Local71.5…86.5 is the **Ø5.990…5.998 bearing journal**, length15. Local86.5…95 is M6×0.5 retainer thread. Keep shoulder/washer contact faces square and parallel within0.01 and the journal/lead axis coaxial within0.01. Maximum shoulder fillet is0.15, below the EZO0.2 limit. Polish journal/contact faces to the specified Ra0.4 target and inspect the actual fits. Threads use the specified gauge classes; a nominal cylinder in SCAD is not a finished thread.

The 30×15×30 L03 housing occupies (445,−53.5,77). Its through bore isØ6.4; its two Ø12.03…12.05 bearing wells are4.5 deep from opposite Y faces. This leaves the central **6 mm wall at Y−49…−43**. Fit two **EZO F6-12M**,6×12×4.5 thrust bearings, with each housing washer against the central wall and each shaft washer facing outward to the rotating shoulder/retainer. The housing washer's6.2 clearance bore and the shaft washer's11.8 outer diameter are different parts: do not reverse them. The Ø10 shaft shoulder satisfies the maker's9.6 minimum abutment; the6.4 housing opening is below its8.4 maximum. The wells centre the12 mm housing washers while clearing the11.8 rotating washers. Do not substitute another manufacturer's rating or an unverified bearing variant.

Slide the first bearing onto the shaft, the housing between the bearings, then the second bearing, the Ø10/Ø6.1×1 washer and two **AF10×3.2 M6×0.5 locknuts**. Nominal stations are bearings−53.5…−49 and−43…−38.5, washer−38.5…−37.5, nuts−37.5…−34.3…−31.1, shaft end−30. Adjust the first nut to remove detectable axial play without binding; acceptance is ≤0.01 mm measured reversing play and smooth hand rotation. Counterhold it while locking the second nut. No bearing preload is inferred from the2220 N catalogue static rating. The two opposed bearings transmit both signs of axial force into the carriage housing; they do not transmit screw rotation into the force cell.

The housing mounts to the writer roof through two Ø6/Ø3.2×6 spacers at (450,−46)/(470,−46), using M3×16 with0.5 washers. The roof is52×70×6 at (434,−55,113), carried on four Ø6/Ø3.2×29 spacers at X456/464,Y1/9. M3×45 roof screws engage the replacement slider by about9.5 mm; its taps are11 deep. The replacement36×20×18 slider stays at (442,−5,66). Line-ream its two guide bores to6.010…6.020 for inspected ground shafts5.994…6.000, with20 mm shaft spacing. The four vertical spacer taps are separated from the shaft bores by X, not drilled through them. Verify smooth travel before connecting the cell. Retained M03 guide posts must have matching clear fits and their radial clamps secured after alignment.

## Fixed nut and actual push/pull path

The fixed nut beam is50×15×20 at (435,−100,82), on two8×15×70 legs at X435/477,Y−100,Z12. The bronze bush has frontØ14×2 flange Y−102…−100, mainØ10×15 body Y−100…−85 and an M10×0.75 rear thread Y−85…−80. Its internal M6×0.5 thread is continuous. The beam bore is10.02…10.04. The main bush has a0.5 deep index flat at X464.5; two retained soft-tip M3 screws at Y−95/−90 bear on that flat. An **AF14×4 M10×0.75 nut** at Y−85…−81 captures the bush from the other side. This is a flange-and-nut axial capture in both directions, rather than a press fit or a friction-only set screw. The soft-tip screws resist bush rotation; the flange and retaining nut take axial force.

The legs use M3×25 bottom screws through the extension/brace stack and M3×25 top screws through the20 mm beam into their top taps. Confirm actual washer stacks and remaining thread depth before tightening. With the carriage retracted15 mm, the moving housing's front face isY−68.5, while the bush ends atY−80, leaving11.5 mm. The lead thread still passes through the complete fixed nut. Do not shorten that clearance by moving the nut back into the M03 position.

The load path is **fixed nut → rotating shaft → opposed thrust bearing → carriage housing/roof → rear spherical link → cell → front spherical link → instrument clevis**. The original ball-ended push-only micrometer does not replace this mechanism. A free-turning knob, a measured reversing-play check, and a cell-zero check while turning unloaded are required. The catalogue bearing load capacity does not establish alignment, fixture strength, backlash, force calibration or specimen travel. The sensor is downstream of the screw, guide friction and bearing compliance; displacement is still measured on the instrument carrier after the cell.

## Both miniature cell connectors

Use the **FUTEK FSH00103** on the horizontal axis X460,Z92, with rear/front load faces at Y5/24.1. The front joint is an **igus KBRM-03 without MH** with pin centreY48 and female mouthY29.5; the rear mirrors it at pinY−18.9 and mouthY−0.4. The maker's18.5 pin-to-mouth dimension creates a real5.4 mm cell-face-to-mouth gap. The rear fork sits at (447,−26.9,87). Replace the M03 front cell fork with S05 at (447,40,87), on the same existing carrier holes. Both have a **10.2 mm inner slot**, providing clearance for the8 mm neck and a ±2° qualification envelope. The old8.2 slot is not used for these commercial spherical ends.

Each C01 custom stud has an **M3×0.5 spigot2.20±0.05 long**, a **hexAF5 shoulder2.4 long**, and **8.5 mm external M3×0.5** on the other side: total13.1. The blind tip chamfer is at most0.10; the rod-end tip chamfer at most0.15. Nominal rod-end engagement is5.5 mm; after the specified0.20 mm combined margin it remains above the maker's5 minimum. The8 mm available female depth leaves2.5 mm nominal nose clearance. M3 AF5×2.4 jamnuts fit in the external gap. Cell engagement remains below the maker's2.8 mm depth even with the stated tolerance. Do not bottom a longer ordinary stud in the cell or compensate by clamping its body.

Fit the6 mm spherical ball between two **OD5.5/ID3.1×2.10±0.01 spacers** in each10.2 slot. The custom pin has aØ5×2 head, aØ2.994…3.000 shoulder26.2 long, and M2×0.4×5 tip. A0.5 washer withID3.2 clears the beginning of the shoulder; two M2 locknuts retain it. Lightly clamp the inner ball through the spacers while preserving free housing articulation. Verify the maker's supplied ball width; the MH variant has a different width and cannot silently use this stack. Use counterholding tools on the stud/rod-end flats. Do not wind the cell body to tighten a joint or let its non-loading surfaces touch the roof, fork or cable restraint.

Manufacturing dimensions specify the connection but do not invent a FUTEK installation torque. Obtain and follow the applicable maker procedure. The igus maximum thread/ball torques in the source document are upper component limits, not target sensor assembly torques. Commission with zero shift, free articulation and installed tension/compression calibration checked. The cell's approximately29 µm nominal deflection at5 N makes screw rotations unsuitable as displacement readings. Its horizontal self-weight and cable effects belong in installed calibration. The strain-relieved cable loop must not pull a free link into a fork wall.

## Central travel catches and fitted water rod

The front/rear20×10×86 catch posts sit at (450,93,12)/(450,120,12). Each has an M8×0.5 transverse thread on X460,Z92, an18 mm-deep M5 bottom tap, and aØ2 anti-yaw dowel. Base-overlay holes are at (460,98)/(460,125), dowels at (466,98)/(466,125). Fit M5×25 base screws with the specified washer stack and check bottom clearance. These posts put the catch force through the same X/Z line as the writer and clay interface, avoiding the large yaw moment of a single outer-edge catch.

The two T02 catches are **M8×0.5,12.7 long, with a3.5 through bore**. Their adjusting faces have twoØ1 holes1.5 deep atR2.8:5.6 pitch. These holes leave at least0.55 mm to the central bore and approximately0.375 mm to the conservatively assumed thread root. The earlier M6 end-drive geometry is not used. The separate1 mm steel strap pinspanner has press holes0.980…0.985 andØ0.994…1.000 pins2.5 long, protruding1.5. Insert it only while stopped, then remove it completely. Retained soft-tip M3 grubs lock the catches; inspect with a3.3 bore gauge after locking, rather than assuming the bore stayed round. The soft nose is captive in its screw, not a loose brass slug that could fall against the rod.

The write target is a **6×6×6 flat block**, cross-bored3.1 along X, centred (460,110,92), held by the rear instrument pin and2.1 mm spacers. Its front/back faces areY107/113. Catch tips at **Y106.7/113.3** give nominal±0.30 mm gaps, set and measured within±0.02. This encloses the±0.25 initial operating range. A conditional0.5 mm range would require a separately accepted±0.55 catch setting; it is not obtained by leaving the initial setting unchanged. The hollow tips overlap the flat6 mm target, so the receipt uses a conservative inscribed contact area rather than the fullØ8 annulus. Stop contact ends the run; no impact rating is established.

The M04 rear water clevis also uses a10.2 slot on the old rear mounting holes, clearing the8 mm catch tips with margin. For reads, replace the flat target with the rod's **6 mm flat eye head**, with the same pin/spacer geometry. Clamp its side faces to remove reversing pin clearance; this is a rigid connection, not the spherical cell joint. Independent high-rate verification of the resulting rod-to-diaphragm transfer remains required. ItsØ3 stem passes through the rear catch's3.5 bore. Establish lateral alignment/runout within0.10 mm and verify no contact through the actual displacement window. A clear CAD hole is not evidence of no dynamic rubbing.

The front water head occupiesY107…113; itsØ3 stem endsY137.5, with RH M3 thread fromY129.6. The **AF5×14 RH/LH turnbuckle** occupiesY132…146:6 mm full RH thread from its front,6 mm full LH thread from its rear. Flat-bottom tap bores provide the recorded runout; do not add an unrecorded twist-drill point. The rear LH stud is11.3984 long, Y140.5…151.8984. Jamnuts areY129.6…132 and146…148.4. The front jamnut fits inside the rear post's7.5 pilot clearance for its0.4 mm nominal overlap, with3.6 mm to the hollow screw end. It remains accessible outside the post; confirm clearance throughout adjustment.

The bonded dry boss is **Ø8×4**, frontY149.3984/back153.3984 for the nominal thin free seal stack. Its flat-bottomØ2.5 bore is3.3 deep; bottom-tap2.5 mm full LH thread, leaving≥0.7 solid bond land. Do not use a twist drill that punctures the rear face. The0.25 mm turnbuckle adjustment range maintains sufficient internal engagement without rotating the rod head or bonded boss. RH/LH pitch gives1 mm/revolution, approximately2.78 µm/degree, as command geometry. Wet equilibrium, rod force and actual displacement determine zero. Lock both jamnuts while counterholding, then recheck zero and rubbing. Bond material, seal compression and wet diaphragm tangent response require their own accepted commissioning record.

## Strings, hood and corrected drive mount

Use the fully dimensioned `retainers_guard/` subassembly. It supplies polishedØ6 nut/saddle bars, two-wrap capstans with separate pressure shoes, guided M4×0.7 right-hand tension cartridges, custom hinges/latches and the polycarbonate hood. The manufactured line clamps replace the old unspecified eye/knot interface. The bars preserve the X60/X560 bearing datums at topZ124; actual curved contact and installed length are measured. Proof grip at the intended load and confirm nylon is not cut. The initial per-string25 N and bank100 N declarations remain conditional on the actual line and clamps. The hood is a physical barrier whose containment must be tested; its dimensions do not constitute an impact certification.

The drive bracket is for **DAEX-13-4SM,4 Ω/3 W**. The manufacturer's drawing/purchased revision governs its≥20.2×41×9 keepout, not the conflicting smaller product-page dimensions. The bracket's front-edgeØ6.2 reliefs clear the existing rear-clevis M3 heads. Its two carrier taps are now **X457/463,Y113.6**, at least3.5 mm full M2 thread within a maximum5 mm total bore/runout depth and at least1 mm bottom land, with **M2×6 screws, headØ≤3.8, no oversized washers**: nominal3 mm engagement leaves the screw clear of the blind bottom. The relief/hole/head clearances are in the subassembly receipt. The physical amplifier supply is governed by the electronics override; do not connect a4 Ω replacement using an unreviewed old8 Ω amplifier assumption.

The drive addition is budgeted at24.806 g, including the bracket's conservative solid volume, motor allowance and fasteners. Weigh the complete installed moving structure against the existing0.350 kg cap, including the thicker boss, rod share, targets, accelerometer and cable traction. None of the new detached writer-stage mass belongs to the free-read carrier. Neither the motor's nominal power nor its free resonance supplies calibrated force at the four musical notes.

## Exact manual write-to-read transition

Start from a recorded state with **rear water rod removed**, flat catch target installed, writer front pin engaged, stops set, hand display live, and raw force/displacement recording. Complete the prescribed ramp/hold/unload while preserving the raw DC baseline. Record the actual end time. Latch/hold the manual screw only as the protocol specifies; do not call a subsequent material relaxation a zeroing correction.

Remove the writer front-pin retainer and pin without dragging the carrier, then retract the writer15 mm and confirm a visible gap. Record that operation and the changed force path. Remove the rear flat target/pin, insert the water-eye/rod, fit its spacers/pin, set the wet-zero turnbuckle and lock it while checking carrier position, preload and bore clearance. Record every step's start/end and the measured settling/dwell. Verify the proper mode, absence of catch contact, gain/sensor state and valid dynamic displacement conversion before a read. If a step changes residual geometry or stress outside the registered preparation, the attempted comparison has changed its physical state.

**No transition time has been measured. These manual operations are not instantaneous and are not claimed to fit a2 s task window.** The present history core that ends with1 s cycle rest plus1 s end rest cannot be registered for this apparatus merely by assigning read time zero. Registration stays blocked until a measured transition interval fits an accepted protocol or the mathematical task owner registers a new core including that interval and its uncertainty. The mechanical parts do not silently rewrite the task timing.

Before operating a built kit, inspect the machined fits and threads, compare actual commercial revisions, qualify joints/seals/bond/grip/guard, calibrate both force signs and after-cell displacement, validate the live stop display and mode changes, and measure wet dynamic motion and transition timing. These are physical acceptance tests, not missing nominal part dimensions. No purchase, fabrication, controller execution or physical pass is reported by this completion kit.
