towre676-cloud/hydrophone/hardware/mechanics_completion/retainers_guard/ASSEMBLY.md

# RG04 string, hood and drive completion

This kit finishes the previously unspecified retainers, manual tension adjustment, hood and exciter mount. The nominal machined dimensions are in `parts.scad` and `generated/cut_list.csv` / `drill_table.csv`. The M03 files are unchanged. Use `rg_web_machining("left")` / `("right")` as subtractive tooling on the corresponding original anchor web before assembling this kit. The completed retention and friction performance remains a commissioning measurement; no prototype has been fabricated or tested here.

## String bearing datums and retention

The four string Y coordinates remain 54,66,78,90. Two polished **6 mm diameter × 76 mm long steel bars**, axes along Y, have centres at (60,*,121) and (560,*,121), with ends Y34/110. Their nominal top tangent is Z124. The first therefore supplies the nominal X60 nut and the second the nominal X560 afterlength saddle, preserving the 400 mm speaking and 100 mm afterlength geometry used by M03. The true tangent shifts slightly with string angle, and the finished bearing span must be measured; the ideal formula is not a force calibration. The bars' two supports are centred at Y42/102, outside the string bank. Polish to a requested Ra≤0.8µm, round exposed edges R0.5 and reject burrs or grooves that cut the line.

Mill two pockets in the left web: global X53…55, Y34…50 /94…110, Z108…130. The left holders occupy X53…68, those Y intervals, Z108…132. Right web pockets are X560…565 with the same Y/Z; right holders occupy X550…565. Each 15×16×24 holder has a 6.05mm Y bore at Z121, a 0.6mm pinch slit from the bore to its top, one M4 mount at local (Y8,Z4), a 2mm locating dowel at (Y13,Z4), and a cross-slit M3 pinch bolt at (Y8,Z19). The right and left bore X offsets differ, as recorded in RG01R/L. Use M4×25 with a 0.8mm washer for approximately9.2mm threaded web engagement, and M3×14 with a0.5mm washer for the pinch joint; inspect that neither bolt bottoms against the pocket or an unrelieved surface. The 2×20mm locating dowel spans the 15mm holder and5mm web engagement. Do not use the pinch screw as a sharp point against the string: the string touches the polished bar only.

Expand each original 4.5mm X hole into a vertical, 4.5mm-wide **8.5mm-high tail-pass slot** whose round-end centre heights are global Z120 and124. The slot consequently extends Z117.75…126.25. The line comes over the bar at about124 and drops toward a capstan wrap at120 behind the web. The fixed bar, rather than the remote moving clamp, thus defines the speaking/afterlength boundary. The extra bend loads the fixed end bank; its load and small bar-deflection estimate are included in the receipt, separately from bridge downforce.

Each **left** clamp is an18×11.5×12 aluminium block at X17…35, Y=yc−5.75…yc+5.75, Z104…116. Two M2×25 screws through its X holes attach to new M2 taps in the rear web face X35; use thin washers and verify at least6mm engagement without bottoming. The slot and clamp mounting holes are independent. Its capstan centre is X25,Y=yc−3. The pin is turned from certified17-4PH H900 or an equivalent steel with a specified minimum0.2%yield strength of600MPa: **M3×0.5 stem4mm long, Ø6 barrel9mm long, Ø8 top flange1mm thick**. The stem sits Z112…116, barrel116…125 and flange125…126. Round all line-contact transitions R0.5. The receipt screens combined bending/torsion at the thread minor diameter; the required supplied material certificate and a proof measurement are separate.

Lead the string from the bearing over the polished Ø6 capstan with **two full wraps**, then place its tail under the POM shoe at X=block origin+12…18, Y=yc−5…yc+5. The shoe is6×10×2, with two1.8mm holes for M1.6×8 screws into5mm-deep M1.6 body taps. Two6×2×0.35mm stopshims under the shoe's Y ends give a nominal0.35mm closure gap for nominal0.50mm line; the tail lies along X between the shims. Seat the shoe on its stops without crushing or stripping the small threads. No coefficient of friction or fastener torque is presented as a proven grip bound. Inspect the tail for flattening/cutting, and retain a visible witness mark outside the shoe. The capstan reduces the demanded tail force only under a measured friction condition; the receipt's μ=0.05/0.10/0.15 values are illustrative assumptions.

Each **right** clamp is18×11.5×18 at nominal X588…606, Y=yc±5.75,Z98…116. A50mm M4×0.7 stud engages its front X face by10mm, at Y=yc,Z104. A48mm-long,3mm guide pin engages the body by8mm at Y=yc,Z110 and passes through a3.1mm web guide hole; it stops the clamp rotating while the nut turns. Add the new4.5mm stud hole and3.1mm guide hole to the web at those heights. The standard0.8mm washer bears on the right web face X580. The adjustment nut occupies580.8…584 and the second M4 jam nut584…587.2. The body starts588, leaving0.8mm clearance at the low end. Use standard M4 nuts, AF7, height3.2; the stud remains nonrotating. Holding the first nut while tightening the second preserves the setting.

Nominal manual travel is **0…8mm in +X**, or11.43 turns of0.7mm pitch. At the far end the body reachesX614, and the guide still spans the entire20mm web. Adjacent11.5mm bodies on12mm centres have0.5mm nominal clearance. Coarsely pull and seat the tail while unloaded before fine tensioning; the8mm mechanism is an adjustment range, not a promise that an arbitrary slack line can be tensioned without resetting the tail clamp. Record any adjustment as a state-changing action. There is no motor or automatic retune.

A primary manufacturer candidate is Sufix Superior Mono Leader **SUFML30100C**, labelled0.50mm/30lb. The label corresponds to about133N; it is not an installed working-load or knot/clamp rating. Measure actual diameter and mass per length, retain the spool identity and do not silently reuse the illustrative density. The installed limits remain25N per string and100N total. Qualify a short retainer coupon behind a closed enclosure at a predefined target such as37.5N before commissioning the long bank, without exceeding the line or fixture's separately approved capacity. The target is a proposal, not a performed proof test. Any slip, whitening, cut or progressive creep at the clamp rejects that configuration. The main instrument is not the first destructive grip-test fixture.

## Closed hood, hinges and tuning access

The hood uses **3mm solid polycarbonate**, not acrylic. The top is625×125 at X0…625,Y18…143,Z170…173. Front and rear sheets are625×65 at Y18…21 and140…143,Z105…170. End panels are3×119×65 at X0…3/622…625,Y21…140,Z105…170. The rightward overhang encloses the tuner at its X614 maximum; it intentionally extends beyond the600mm base. Four15×15×2 aluminium corner angles,65mm long, join the sheets using M3 through-bolts, nuts and broad washers. Mirror the angles at the rear/right corners, as the assembly module does; their solid legs belong inside the hood, never inside the polycarbonate.

Six fixed stanchions are centred X30/300/580,Y8/154. Their20×20×6 feet start atZ12 and10×10×147 posts atZ18, ending165. Add the six3.4mm base holes at those centres. M3×25 screws from below the12mm base pass through the6mm feet and engage the post's bottom tap, with a thin washer; verify lengths against the actual stack. Two605×10×5 rails run X20…625,Y3…13 and149…159,Z165…170, mounted with M3×12 screws into the post tops. The rear posts lie outside the water cell's X span; the rear rail is above the135mm wall top.

Panel-mount centres are X30/300/580 at **Z117 and157**. Use4.2mm sheet holes with metal sleeves OD4/ID3.2/length3 and OD9 washers to avoid crushing the plastic while tightening. Front5mm stand-off spacers and M3×16 screws reach the front posts; rear6mm spacers and M3×18 screws reach the rear posts. The post's Y taps are through10mm, so the stated rear screw does not bottom at an8mm blind depth. The lower panel holes moved to117 to clear the tuning access notch. These dimensions supersede any preliminary RG04 message.

Two fully machined hinges use fixed forks RG18 at X98/498,Y140,Z170 and matching lid leaves RG19 at X100/500,Y128,Z173. Each axis is along X, at Y150,Z181. A fixed34×20×18 fork has a4mm base and5mm ears with a14mm opening. A30×30×14 lid leaf has a3mm base and12mm ear, leaving1mm on each side. Ream4.05mm coaxial bores and use a ground4h6×30mm pin with1.5mm keeper holes at1.5/28.5mm from the ends. The closed lid is restrained by two front M4×8 thumb screws and washers into4mm-thick latch flanges, at (110,31) and(510,31); the4.5×6.5mm lid slots allow small assembly/thermal movement. Hinge and latch attachment holes are in the tables. Allow about313mm height when the lid is opened90°; that is a service envelope, not the closed188mm hardware height.

The front panel's lower edge has a **14mm-wide ×5mm-high notch at X576…590,Z105…110**, aligned with the tuning nuts atZ104. A thin7AF offset spanner can reach from below the hood without lifting the lid; confirm its actual swept clearance before tensioning. Adjust only with excitation stopped, keep the line covered and use the validated tension measurement. Opening the lid is for unloaded/stringing service. The hood has an open lower region, no interlock and no performed projectile/reach-standard test. It is a concrete projectile/splash hood; it is not represented as a certified machine enclosure or an automatic hands-exclusion system. Reject cracked/crazed sheet or insecure latch/hinge retention.

## Small Y-axis exciter mount

The old DAEX25 '25mm' designation was a voice-coil diameter; that model's body is much larger. This completion specifies **Dayton DAEX-13-4SM,3W nominal,4Ω**. Its current drawing, not its product-title diameter, governs the keepout: use at least **20.2×41×9mm**, and measure the purchased revision. A product-page outline of18.5×38.5×8mm must not shrink this mount. The4Ω electrical load must match the electronics configuration. A950Hz free-air resonance and3W thermal rating establish neither useful261–391Hz force nor a safe diaphragm stroke.

Machine RG22 from a32×10×46 aluminium blank, globally X444…476; mill away the unused side regions, retaining the24mm-wide land and two4×3×8 cable ears. Its3mm foot occupies global X448…472,Y110…120,Z119…122; its vertical3mm vane is Y117…120,Z119…165. Two triangular3mm-wide gussets at the X edges support the vane from the7mm-deep foot over35mm height. Cut two **Ø6.2 through semicircular reliefs centred at local(X8,Y0) and(X24,Y0)**, globally(452,110) and(468,110), through the entire blank height. These clear the rear-clevis M3 screw heads atZ119…122. The reliefs intentionally remove the front portions of the gussets; a continuous3.9mm-deep strip remains ahead of the vane and both gussets remain attached to the foot and vane. The mount uses **two M2 blind carrier taps at(457,113.6) and(463,113.6),with at least3.5mm full thread and maximum5mm total blind bore/runout depth fromZ119**, matched by Ø2.4 foot holes at local(13,3.6)/(19,3.6). Use **M2×6 screws with cylindrical heads OD≤3.8mm and no washers**, giving3mm thread engagement and at least0.5mm full-thread reserve; a suitable bottoming tap uses the1.5mm bore runout allowance and leaves at least1mm solid bottom land. The6mm head spacing leaves2.2mm between the specified head envelopes. The closest M2 clearance bore is1.86mm from the edge of a clevis-head relief, while its head has1.16mm clearance. These coordinates supersede earlier454/466 proposals. The taps remain above the plate bottom.

The exciter's factory adhesive attaches to the vane's +Y face, with its body keepout X449.9…470.1,Y120…129,Z121.5…162.5. This gives1.9mm side and2.5mm vertical margins on the land and11mm nominal separation from the rear hood. Follow the manufacturer's adhesive installation guidance and record the exact mount; no applied clamp or screw touches the moving motor body. Use the two2mm holes on the side ears, at global X446/474,Z161, only for a **slack** cable loop on one side outside the motor keepout, with fixed-frame strain relief farther away. Do not transmit cable tension to the bridge.

The conservative moving addition is approximately12.8g of bracket, a10g motor budget and2g hardware/cable budget: about24.8g. The product-page6.7g is not substituted for weighing the purchased revision. Add this to the entire M04 moving assembly, including any new connectors, and enforce the350g screening cap only after weighing. The gusset bracket has its own transfer function; neither this geometry nor an electrical loopback is a calibrated mechanical force port. Actual wet diaphragm motion and all other commissioning requirements remain separate.

## Reproduction and scope

Run `python hardware/mechanics_completion/retainers_guard/build.py`. It regenerates the cut/drill tables and screening receipt using only Python's standard library. OpenSCAD's `rg_part` selects the individual holders, clamp bodies, pin, shoe, lid, hinge parts or driver bracket. Integrators should use the prefixed modules, and should subtract `rg_web_machining` from the original web model; do not overlay new bodies on uncut solid webs. The receipt checks nominal clearances and reports conditional bar/pin loads. Friction, clamp strength, sheet impact behaviour, assembled mass, sensor conversion and physical computing remain unmeasured. No purchase, fabrication, calibration or hardware command was performed.
