towre676-cloud/hydrophone/hardware/commissioning/writer_references.blank.csv

channel | split | level_id | direction | approach | raw_V | reference_SI | reference_error_SI | raw_error_V | temperature_C | excitation_V | settled | reference_evidence_id | data_origin | planned_reference_SI
force | development | development--5 | negative | loading |  |  |  |  |  |  |  |  |  | -5
force | development | development--5 | negative | unloading |  |  |  |  |  |  |  |  |  | -5
force | development | development--3 | negative | loading |  |  |  |  |  |  |  |  |  | -3
force | development | development--3 | negative | unloading |  |  |  |  |  |  |  |  |  | -3
force | development | development-0 | positive | loading |  |  |  |  |  |  |  |  |  | 0
force | development | development-0 | positive | unloading |  |  |  |  |  |  |  |  |  | 0
force | development | development-3 | positive | loading |  |  |  |  |  |  |  |  |  | 3
force | development | development-3 | positive | unloading |  |  |  |  |  |  |  |  |  | 3
force | development | development-5 | positive | loading |  |  |  |  |  |  |  |  |  | 5
force | development | development-5 | positive | unloading |  |  |  |  |  |  |  |  |  | 5
force | validation | validation--4 | negative | loading |  |  |  |  |  |  |  |  |  | -4
force | validation | validation--4 | negative | unloading |  |  |  |  |  |  |  |  |  | -4
force | validation | validation--1 | negative | loading |  |  |  |  |  |  |  |  |  | -1
force | validation | validation--1 | negative | unloading |  |  |  |  |  |  |  |  |  | -1
force | validation | validation-1 | positive | loading |  |  |  |  |  |  |  |  |  | 1
force | validation | validation-1 | positive | unloading |  |  |  |  |  |  |  |  |  | 1
force | validation | validation-4 | positive | loading |  |  |  |  |  |  |  |  |  | 4
force | validation | validation-4 | positive | unloading |  |  |  |  |  |  |  |  |  | 4
position | development | development--5 | negative | loading |  |  |  |  |  |  |  |  |  | -0.00025000000000000001
position | development | development--5 | negative | unloading |  |  |  |  |  |  |  |  |  | -0.00025000000000000001
position | development | development--3 | negative | loading |  |  |  |  |  |  |  |  |  | -0.00015000000000000001
position | development | development--3 | negative | unloading |  |  |  |  |  |  |  |  |  | -0.00015000000000000001
position | development | development-0 | positive | loading |  |  |  |  |  |  |  |  |  | 0
position | development | development-0 | positive | unloading |  |  |  |  |  |  |  |  |  | 0
position | development | development-3 | positive | loading |  |  |  |  |  |  |  |  |  | 0.00015000000000000001
position | development | development-3 | positive | unloading |  |  |  |  |  |  |  |  |  | 0.00015000000000000001
position | development | development-5 | positive | loading |  |  |  |  |  |  |  |  |  | 0.00025000000000000001
position | development | development-5 | positive | unloading |  |  |  |  |  |  |  |  |  | 0.00025000000000000001
position | validation | validation--4 | negative | loading |  |  |  |  |  |  |  |  |  | -0.00020000000000000001
position | validation | validation--4 | negative | unloading |  |  |  |  |  |  |  |  |  | -0.00020000000000000001
position | validation | validation--1 | negative | loading |  |  |  |  |  |  |  |  |  | -5.0000000000000002e-05
position | validation | validation--1 | negative | unloading |  |  |  |  |  |  |  |  |  | -5.0000000000000002e-05
position | validation | validation-1 | positive | loading |  |  |  |  |  |  |  |  |  | 5.0000000000000002e-05
position | validation | validation-1 | positive | unloading |  |  |  |  |  |  |  |  |  | 5.0000000000000002e-05
position | validation | validation-4 | positive | loading |  |  |  |  |  |  |  |  |  | 0.00020000000000000001
position | validation | validation-4 | positive | unloading |  |  |  |  |  |  |  |  |  | 0.00020000000000000001
temperature_C | development | temp-development-10 | positive | heating |  |  |  |  |  |  |  |  |  | 10
temperature_C | development | temp-development-10 | positive | cooling |  |  |  |  |  |  |  |  |  | 10
temperature_C | development | temp-development-20 | positive | heating |  |  |  |  |  |  |  |  |  | 20
temperature_C | development | temp-development-20 | positive | cooling |  |  |  |  |  |  |  |  |  | 20
temperature_C | development | temp-development-30 | positive | heating |  |  |  |  |  |  |  |  |  | 30
temperature_C | development | temp-development-30 | positive | cooling |  |  |  |  |  |  |  |  |  | 30
temperature_C | validation | temp-validation-15 | positive | heating |  |  |  |  |  |  |  |  |  | 15
temperature_C | validation | temp-validation-15 | positive | cooling |  |  |  |  |  |  |  |  |  | 15
temperature_C | validation | temp-validation-25 | positive | heating |  |  |  |  |  |  |  |  |  | 25
temperature_C | validation | temp-validation-25 | positive | cooling |  |  |  |  |  |  |  |  |  | 25
