towre676-cloud/hydrophone/hardware/commissioning/examples/writer_references.synthetic.csv

channel | split | level_id | direction | approach | raw_V | reference_SI | reference_error_SI | raw_error_V | temperature_C | excitation_V | settled | reference_evidence_id | data_origin
force | development | development--5 | negative | loading | 1.0235960144927536 | -5 | .002 | .00005 | 20 | 2.5 | true | SYNTHETIC-REF | synthetic_demo
force | development | development--5 | negative | unloading | 1.0235054347826087 | -5 | .002 | .00005 | 20 | 2.5 | true | SYNTHETIC-REF | synthetic_demo
force | development | development--3 | negative | loading | 1.1141757246376811 | -3 | .002 | .00005 | 20 | 2.5 | true | SYNTHETIC-REF | synthetic_demo
force | development | development--3 | negative | unloading | 1.1140851449275362 | -3 | .002 | .00005 | 20 | 2.5 | true | SYNTHETIC-REF | synthetic_demo
force | development | development-0 | positive | loading | 1.2500452898550725 | 0 | .002 | .00005 | 20 | 2.5 | true | SYNTHETIC-REF | synthetic_demo
force | development | development-0 | positive | unloading | 1.2499547101449275 | 0 | .002 | .00005 | 20 | 2.5 | true | SYNTHETIC-REF | synthetic_demo
force | development | development-3 | positive | loading | 1.3859148550724638 | 3 | .002 | .00005 | 20 | 2.5 | true | SYNTHETIC-REF | synthetic_demo
force | development | development-3 | positive | unloading | 1.3858242753623189 | 3 | .002 | .00005 | 20 | 2.5 | true | SYNTHETIC-REF | synthetic_demo
force | development | development-5 | positive | loading | 1.4764945652173913 | 5 | .002 | .00005 | 20 | 2.5 | true | SYNTHETIC-REF | synthetic_demo
force | development | development-5 | positive | unloading | 1.4764039855072464 | 5 | .002 | .00005 | 20 | 2.5 | true | SYNTHETIC-REF | synthetic_demo
force | validation | validation--4 | negative | loading | 1.0688858695652175 | -4 | .002 | .00005 | 20 | 2.5 | true | SYNTHETIC-REF | synthetic_demo
force | validation | validation--4 | negative | unloading | 1.0687952898550726 | -4 | .002 | .00005 | 20 | 2.5 | true | SYNTHETIC-REF | synthetic_demo
force | validation | validation--1 | negative | loading | 1.2047554347826086 | -1 | .002 | .00005 | 20 | 2.5 | true | SYNTHETIC-REF | synthetic_demo
force | validation | validation--1 | negative | unloading | 1.2046648550724637 | -1 | .002 | .00005 | 20 | 2.5 | true | SYNTHETIC-REF | synthetic_demo
force | validation | validation-1 | positive | loading | 1.2953351449275363 | 1 | .002 | .00005 | 20 | 2.5 | true | SYNTHETIC-REF | synthetic_demo
force | validation | validation-1 | positive | unloading | 1.2952445652173914 | 1 | .002 | .00005 | 20 | 2.5 | true | SYNTHETIC-REF | synthetic_demo
force | validation | validation-4 | positive | loading | 1.4312047101449274 | 4 | .002 | .00005 | 20 | 2.5 | true | SYNTHETIC-REF | synthetic_demo
force | validation | validation-4 | positive | unloading | 1.4311141304347825 | 4 | .002 | .00005 | 20 | 2.5 | true | SYNTHETIC-REF | synthetic_demo
position | development | development--5 | negative | loading | 2.9000400000000002 | -0.00025000000000000001 | .0000005 | .00005 | 20 | 2.5 | true | SYNTHETIC-REF | synthetic_demo
position | development | development--5 | negative | unloading | 2.8999600000000001 | -0.00025000000000000001 | .0000005 | .00005 | 20 | 2.5 | true | SYNTHETIC-REF | synthetic_demo
position | development | development--3 | negative | loading | 2.9400400000000002 | -0.00015000000000000001 | .0000005 | .00005 | 20 | 2.5 | true | SYNTHETIC-REF | synthetic_demo
position | development | development--3 | negative | unloading | 2.9399600000000001 | -0.00015000000000000001 | .0000005 | .00005 | 20 | 2.5 | true | SYNTHETIC-REF | synthetic_demo
position | development | development-0 | positive | loading | 3.0000399999999998 | 0 | .0000005 | .00005 | 20 | 2.5 | true | SYNTHETIC-REF | synthetic_demo
position | development | development-0 | positive | unloading | 2.9999600000000002 | 0 | .0000005 | .00005 | 20 | 2.5 | true | SYNTHETIC-REF | synthetic_demo
position | development | development-3 | positive | loading | 3.0600399999999999 | 0.00015000000000000001 | .0000005 | .00005 | 20 | 2.5 | true | SYNTHETIC-REF | synthetic_demo
position | development | development-3 | positive | unloading | 3.0599599999999998 | 0.00015000000000000001 | .0000005 | .00005 | 20 | 2.5 | true | SYNTHETIC-REF | synthetic_demo
position | development | development-5 | positive | loading | 3.1000399999999999 | 0.00025000000000000001 | .0000005 | .00005 | 20 | 2.5 | true | SYNTHETIC-REF | synthetic_demo
position | development | development-5 | positive | unloading | 3.0999599999999998 | 0.00025000000000000001 | .0000005 | .00005 | 20 | 2.5 | true | SYNTHETIC-REF | synthetic_demo
position | validation | validation--4 | negative | loading | 2.9200400000000002 | -0.00020000000000000001 | .0000005 | .00005 | 20 | 2.5 | true | SYNTHETIC-REF | synthetic_demo
position | validation | validation--4 | negative | unloading | 2.9199600000000001 | -0.00020000000000000001 | .0000005 | .00005 | 20 | 2.5 | true | SYNTHETIC-REF | synthetic_demo
position | validation | validation--1 | negative | loading | 2.9800399999999998 | -5.0000000000000002e-05 | .0000005 | .00005 | 20 | 2.5 | true | SYNTHETIC-REF | synthetic_demo
position | validation | validation--1 | negative | unloading | 2.9799600000000002 | -5.0000000000000002e-05 | .0000005 | .00005 | 20 | 2.5 | true | SYNTHETIC-REF | synthetic_demo
position | validation | validation-1 | positive | loading | 3.0200399999999998 | 5.0000000000000002e-05 | .0000005 | .00005 | 20 | 2.5 | true | SYNTHETIC-REF | synthetic_demo
position | validation | validation-1 | positive | unloading | 3.0199600000000002 | 5.0000000000000002e-05 | .0000005 | .00005 | 20 | 2.5 | true | SYNTHETIC-REF | synthetic_demo
position | validation | validation-4 | positive | loading | 3.0800399999999999 | 0.00020000000000000001 | .0000005 | .00005 | 20 | 2.5 | true | SYNTHETIC-REF | synthetic_demo
position | validation | validation-4 | positive | unloading | 3.0799599999999998 | 0.00020000000000000001 | .0000005 | .00005 | 20 | 2.5 | true | SYNTHETIC-REF | synthetic_demo
