towre676-cloud/hydrophone/(commit log)

2026-10-24 Integrate physical design and develop exact computing workbench
    Preserve the coordinated design packet, CAD, reports and original deliverables. Add grouped bounded-observation planning, runtime decisions, rigorous finite-hold memory bounds, Dyletsky tuning and spelling-preserving scores, and raw acquisition auditing.
    Validation: 38 unit tests; 600 original panel comparisons; 16 grouped-panel comparisons; 108 planner/exhaustive comparisons; design arithmetic and passive model replayed. All computing remains offline and physically unqualified.
    [Fusion_Instrument_Layout.scad, free_ringdown.csv, synthetic_sweep.csv]
2026-10-24 Integrate recovered Dyletsky engines and instrument signal computing
    Preserve the parallel exact computing workbench and older design archive. Add the complete revised physical design, source engine replay, deterministic common-input WAV rendering, raw multitone and slow-mechanics analysis, and explicit score/run compatibility.
    Validation: 67 Python tests, 21 independent static engine checks, the 600-case Fusion replay and passive-model checks pass. Hardware execution remains disabled.
2026-10-24 Develop M03 physical build and synchronized acquisition
    Add dimensioned OpenSCAD assembly, fabrication drawing, 32 cut-list entries, 126 drilling entries, reproducible load screens, sourced E01 electronics and a 22-row BOM. Add stationary recovered-Dyletsky probes, opt-in duplex audio and T7 raw capture, ambiguity-aware electrical alignment, raw-marker clock replay, native-evidence sealing and scoped calibration utilities. Preserve the earlier packet and the parallel computing workbench.
    Validation: 107 Python tests, 11 nominal geometry/load screens, five exact generated-file replays, OpenSCAD compilation, 21 recovered strategy checks, 600 archived Fusion checks and passive-model replay pas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
    [assembly.scad, bom.csv, cut_list.csv, drill_table.csv, params.scad]
2026-10-24 Add preregisterable clay-history tuning evaluation
    Define the shared E4 HOLD/raise5 task, matched write histories, timing, uncertainty, controls and fixed confirmation design. Add development-frozen empirical policies, same-information digital baselines, exact conservative statistics, history-linked action gate and full measurement-cost accounting. Reject reused evidence, leakage, changed protocols and incomplete confirmation.
    Align the physical binding and return handoff with M03. Exercise one stipulated useful coupling and three mandatory null cases, preserving explicit synthetic origin and no demonstrated total-time saving.
    Validation: 161 tests, 49 imported design hashes, five mechanic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
2026-10-24 Complete M04 nominal mechanics, live readout and physical task adapter
    Preserve the Review Hidden Math evaluator and original M03 packet. Add dimensioned captive lead/bearings, real miniature connectors, aligned catches, turnbuckle, line retainers, guard and compact exciter mount. Correct the four-ohm drive supply and add a room-temperature logger profile. Implement a calibration-bound live writer display, commissioning arithmetic, full/reduced episode commands, hash-bound task feature/outcome extraction and source-cost-clock lineage checks.
    Block physical v1 binding for M04's detached inline writer cell: it cannot measure permanent clay reaction after disconnection. Record a separate unreg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
    [assembly.scad, cut_list.csv, drill_table.csv, parts.scad, turning_table.csv, writer_references.blank.csv, writer_references.synthetic.csv, writer_references_with_temperature.synthetic.csv]
2026-10-24 Add corpus-conditioned symphonic composition and playable orchestral works
    Ingest all 1,474 pinned OpenScore editions by 136 composers and 12,741 performed MIDI files representing 49 named pianists. Retain source hashes, licenses, composer/pianist-balanced statistics, quality filtering and composition holdout. Use measured melodic/rhythmic and performance priors in an original thematic composition and expression pipeline.
    Add a sampled virtual orchestra with spelling-dependent recovered Dyletsky cents, independent note expression/vibrato, layered strings, pizzicato, stereo staging and room response. Publish two complete three-movement works, editable scores, MIDI, MP3 and self-contained off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
